AlexisJ16/tapete_interactivo/docs/hardware/grafico/grafico_tapete_A3.pdf

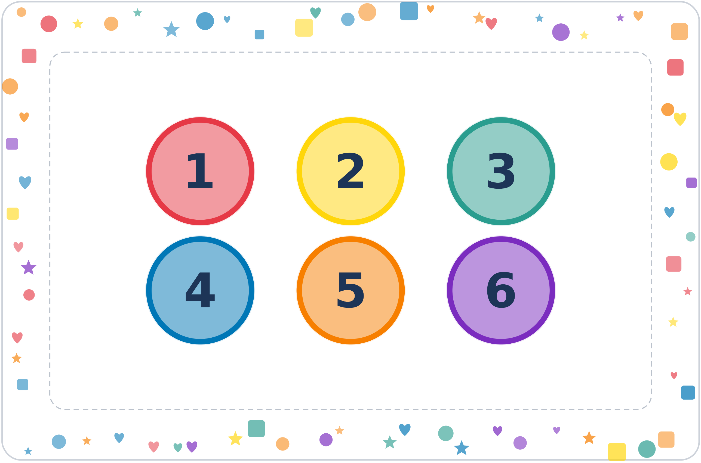
[picture p11: figure]

CALIBRACIÓN 100 mm — medir con regla; debe dar 100 mm exactos

TAPETE INTERACTIVO — plantilla a escala real 39 × 26 cm. IMPRIMIR AL 100% / TAMAÑO REAL — NO usar “ajustar a página”. Recortar por las marcas. Acetato A3 · alinear cada círculo sobre su grupo de LEDs (el borde es decorativo) · verificar la regla de 100 mm antes de montar.
