AlexisJ16/tapete_interactivo/docs/articulo/Desarrollo de tapete interactivo con secuencias de luces y sonidos para implementación en terapias de niños con síndrome de Down V3.docx

# FORMATO ANTEPROYECTO DE TRABAJO DE GRADO

(MODALIDADES INVESTIGACION Y ESTUDIO DE CASO*)

*La modalidad de estudio de caso aplica únicamente para programas de especialización

INFORMACIÓN BÁSICA
Programa académico al cual pertenece el estudiante | Ingeniería Electrónica
Nombre del (los) Estudiante (s): | Andrés Mauricio Restrepo Restrepo Christian Camilo Galeano Saldarriaga
Código o Cédula: 1143961668 1088311365 | E-mail: andres.restrepo03@usc.edu.co christian.galeano01@usc.edu.co | No. Cel.: 3155851907 3168296197
Nombre del director de trabajo de grado | Luis Carlos Rodríguez Timaná Vo Bo director
Título de la propuesta: (máx. 100 caracteres) | Desarrollo de un tapete interactivo que combina secuencias de luces y sonidos como herramienta de apoyo para terapias en niños con síndrome de Down.

Modalidad de Trabajo de Grado

Proyecto de Grado de Investigación | x | Estudio de caso

Grupo de investigación | GIEIAM X COMBA I+D
Línea de investigación (seleccione con una X la línea de investigación) | Logística, operaciones, productividad y gestión de proyectos Instrumentación, automatización y sistemas inteligentes X Gestión y control de la contaminación ambiental Arquitectura de Tecnología Informática Computación Ubicua, Urbana y Móvil Desarrollo de Sistemas Informáticos Redes Inalámbricas para la Inclusión Digital y el Desarrollo Económico

CUERPO DEL ANTEPROYECTO

Introducción

(máximo 250 palabras)

El síndrome de Down, también conocido como trisomía 21, se produce cuando existe una copia adicional del cromosoma 21 en todas las células del individuo. Es considerado uno de los trastornos genéticos más prevalentes a nivel global, con una tasa de ocurrencia de 12,6 por cada 10.000 nacimientos (de Graaf et al., 2015). Los niños que presentan esta condición suelen evidenciar una disminución en la fuerza muscular y alteraciones en el funcionamiento del cerebelo, lo que compromete su equilibrio y control postural. Como consecuencia, su patrón de marcha se torna inestable y se caracteriza por pasos más cortos. Estas condiciones derivan en un retraso en el desarrollo de habilidades motoras gruesas (Okada et al., 2019).

Los juegos de simulación ofrecen un gran potencial terapéutico para personas con neurodiversidad, mejorando sus funciones ejecutivas y promoviendo la inclusión tanto en entornos educativos como terapéuticos. Aunque los resultados son prometedores, se necesita más investigación para optimizar el diseño de los juegos, evaluar sus efectos a largo plazo y estandarizar la calidad de los estudios (Timaná et al., 2024).

Este proyecto busca el desarrollo de un tapete interactivo diseñado para intervenir las habilidades cognitivas y motoras en niños con síndrome de Down, combinando secuencias de luces, sensores de presión, junto con un software de análisis de datos en PC para evaluar el progreso del usuario. El sistema ofrece tres modos de juego diseñados para estimular la memoria de trabajo, planificación motora, velocidad de respuesta y equilibrio. El tapete incluirá secuencias de luz memorizadas y saltos en patrones sobre él.

Planteamiento del problema

(máximo 500 palabras)

Los niños con síndrome de Down enfrentan múltiples retos en su desarrollo cognitivo y motor, los cuales demandan intervenciones especializadas. Uno de los aspectos más críticos es la memoria de trabajo, una función clave para mantener y manipular información de forma inmediata. Las limitaciones en esta habilidad repercuten directamente en la capacidad de los niños para seguir instrucciones, recordar secuencias y comprender información compleja, afectando su rendimiento tanto en actividades cotidianas como en contextos educativos (Covaci et al., 2015).

Además, la planificación y secuenciación motora representan un obstáculo considerable. La ejecución de movimientos en un orden específico, crucial para actividades como vestirse, atarse los zapatos o realizar tareas escolares, se ve comprometida. La coordinación estructurada, necesaria para el desarrollo de habilidades motoras finas y gruesas, también se ve afectada, lo que puede limitar su participación en juegos y deportes.

La velocidad de procesamiento y reacción es otro factor crítico. Los niños con síndrome de Down suelen experimentar tiempos de respuesta más prolongados ante estímulos visuales o auditivos. Esta lentitud puede dificultar su interacción en juegos y actividades que requieren rapidez en la toma de decisiones, así como su capacidad para seguir el ritmo de las clases y las conversaciones (Lukowski et al., 2019).

Las alteraciones en la postura y el control del cuerpo son también comunes. El equilibrio y la coordinación se ven comprometidos, lo que puede afectar su movilidad y desempeño en actividades físicas. Estas dificultades pueden limitar su exploración del entorno y su participación en juegos activos, lo que, a su vez, puede impactar su desarrollo social y emocional (Galli et al., 2008).

A pesar de la existencia de terapias motoras y juegos tradicionales, muchos de estos métodos carecen de la capacidad de proporcionar retroalimentación inmediata y personalizada. La falta de un seguimiento detallado del progreso del niño dificulta la adaptación de los niveles de dificultad, lo que puede resultar en frustración y desmotivación (Okada et al., 2019).

Es imperativo desarrollar un sistema innovador que integre tecnología de sensores y aprendizaje adaptativo. Esta herramienta debe ser capaz de entrenar habilidades cognitivas y motoras de manera dinámica y motivadora, proporcionando retroalimentación inmediata y ajustando los niveles de dificultad según el rendimiento individual de cada niño. La capacidad de medir el desempeño y realizar un seguimiento detallado del progreso permitirá a los terapeutas y educadores adaptar las intervenciones y maximizar el potencial de cada niño.

En este contexto, surge la necesidad de explorar cómo este tipo de soluciones tecnológicas pueden integrarse de manera efectiva en entornos terapéuticos reales. Por tanto, el presente proyecto no solo se enfoca en el desarrollo técnico de un tapete interactivo con estímulos visuales y auditivos, sino también en la evaluación de su comportamiento durante su implementación en sesiones terapéuticas. Así, se plantea como pregunta de investigación: ¿Cuáles son los elementos clave en el desarrollo de un tapete interactivo con luces y sonidos que favorezcan su efectividad como herramienta de apoyo terapéutico para niños con síndrome de Down?

Justificación

(máximo 500 palabras)

Tal como se ha señalado, los niños con síndrome de Down presentan múltiples dificultades en áreas fundamentales del desarrollo, entre ellas la memoria de trabajo, la planificación y ejecución motora, la velocidad de procesamiento y reacción, así como el control postural. Estas limitaciones pueden afectar de manera significativa su calidad de vida, restringiendo su autonomía, su participación en actividades cotidianas y su desarrollo integral (Lukowski et al., 2019).

Por otro lado, las terapias convencionales y los juegos tradicionales empleados en este contexto presentan diversas limitaciones. En muchos casos, no ofrecen retroalimentación inmediata ni personalizada, elemento esencial para que los niños puedan identificar errores, corregirlos y fortalecer su aprendizaje. La ausencia de este tipo de retroalimentación puede disminuir la motivación y dificultar el progreso. Asimismo, la falta de un sistema que registre el avance del niño impide adaptar los niveles de dificultad de manera adecuada, lo cual complica a padres y terapeutas el seguimiento efectivo de la intervención. Además, gran parte de estas actividades no han sido diseñadas considerando las particularidades del síndrome de Down, lo que puede resultar en ejercicios poco retadores o excesivamente complejos, provocando frustración y desinterés en los participantes (Minh et al., 2021).

Ante este panorama, surge la necesidad de desarrollar una solución innovadora que combine los avances tecnológicos con los principios pedagógicos y terapéuticos más actuales. Esta solución debe ser capaz de proporcionar retroalimentación inmediata y personalizada, realizar un seguimiento detallado del progreso del niño y de adaptar los niveles de dificultad de las actividades de manera dinámica.

Se espera que este juego interactivo sea una herramienta valiosa para complementar las terapias tradicionales y para potenciar el desarrollo cognitivo y motor de los niños con síndrome de Down. Al ofrecer una experiencia de aprendizaje interactiva y motivadora, este juego puede ayudar a estos niños a superar sus dificultades y a alcanzar su máximo potencial.

Este proyecto está alineado con dos Objetivos De Desarrollo Sostenible (ODS) de la Organización de las Naciones Unidas (ONU) (Objetivos de Desarrollo Sostenible | Programa De Las Naciones Unidas Para El Desarrollo, n.d.). En primer lugar, contribuye al ODS 3: SALUD Y BIENESTAR, al promover el acompañamiento y la atención especializada a los niños con síndrome de Down; y, en segundo lugar, está alineado con el ODS 10: REDUCCION DE LAS DESIGUALDADES, al contribuir a la inclusión social de esta población.

Objetivos

OBJETIVO GENERAL:

Desarrollar un tapete interactivo que combine secuencias de luces y sonidos como herramienta de apoyo en terapias para niños con síndrome de Down.

OBJETIVOS ESPECIFICOS:

- Diseñar el sistema electrónico del tapete interactivo, que integre sensores de presión, módulos de iluminación LED RGB y componentes de salida de audio para implementarlo en terapias cognitivas y motrices en niños con síndrome de Down.
- Desarrollar el firmware del microcontrolador encargado de la interacción entre los sensores, las secuencias de luces y los sonidos, implementando diferentes modos terapéuticos adaptables a las necesidades de los niños con síndrome de Down.
- Evaluar el comportamiento funcional del prototipo en un entorno terapéutico real.

Marco teórico y estado del arte

(Debe incluir el marco contextual y el marco legal en caso de ser necesario Pueden incluirse figuras y tablas)

(máximo 1500 palabras)

Marco Teórico

1. Síndrome de Down y su impacto en el desarrollo infantil
  1.1 Definición y características generales

El síndrome de Down, también conocido como trisomía 21, es un trastorno genético causado por la presencia de una copia adicional del cromosoma 21. Esta condición afecta múltiples áreas del desarrollo infantil, tanto físico como cognitivo. En el plano físico, es común observar hipotonía muscular, laxitud ligamentosa y retraso en el desarrollo motor grueso, lo que repercute en habilidades como el equilibrio y la coordinación. A nivel cognitivo, se presentan dificultades en funciones como la memoria de trabajo, la atención y la planificación, lo que puede impactar el aprendizaje y la autonomía del niño en contextos escolares y sociales (Okada et al., 2019).

  1.2 Alteraciones motoras en niños con síndrome de Down

Los niños con síndrome de Down presentan hipotonía muscular y dificultades de equilibrio, lo que se traduce en una marcha inestable y retrasos en el desarrollo motor grueso. Estas dificultades no solo afectan su movilidad, sino también su independencia funcional y su interacción con el entorno (Okada et al., 2019).

  1.3 Intervenciones terapéuticas orientadas al desarrollo motor

Diversas terapias, como la fisioterapia y la hipoterapia, han demostrado beneficios importantes. Mientras que la fisioterapia mejora la alineación corporal y fortalece el sistema musculoesquelético, la hipoterapia estimula el sistema vestibular y la orientación espacial, promoviendo un desarrollo motor más equilibrado y eficiente (Bevilacqua Junior et al., 2023).

2. Habilidades motoras: clasificación y evaluación
  2.1 Definición de habilidades motoras

Las habilidades motoras pueden definirse como secuencias aprendidas de movimientos que se combinan de manera coordinada para ejecutar una acción de forma suave, precisa y eficiente, con el propósito de dominar una tarea específica. Estas habilidades no son innatas, sino que se adquieren y refinan progresivamente a través de la práctica, la retroalimentación y la maduración del sistema neuromuscular (van der Fels et al., 2015). Su desarrollo es fundamental para la autonomía del individuo, ya que permiten desde acciones básicas como caminar o alimentarse, hasta tareas más complejas como escribir, jugar o manipular objetos. Estas habilidades se agrupan en distintas categorías funcionales, que incluyen las habilidades motoras gruesas, finas, de coordinación bilateral, control de objetos, y rendimiento cronometrado, entre otras, dependiendo del tipo de actividad, la precisión requerida y la parte del cuerpo involucrada (van der Fels et al., 2015).

  2.2 Tipos de habilidades motoras
- Gruesas: correr, saltar, caminar, equilibrio.
- Finas: escritura, dibujo, manipulación precisa (van der Fels et al., 2015)
- Coordinación bilateral: sincronización de extremidades superiores e inferiores (van der Fels et al., 2015)
- Control de objetos: lanzar, atrapar o manejar herramientas (van der Fels et al., 2015)
- Rendimiento cronometrado: velocidad de ejecución de secuencias motoras.
- Puntuación motora total: indicador global que integra todas las categorías anteriores (van der Fels et al., 2015)
  2.3 Habilidades motoras en el contexto del síndrome de Down

Debido a la hipotonía y la disfunción neuromuscular, los niños con síndrome de Down suelen presentar dificultades en varias categorías motoras, por lo cual es necesario implementar estrategias lúdicas y terapéuticas para su fortalecimiento.

3. Habilidades cognitivas y funciones ejecutivas
  3.1 Definición y componentes principales

Las habilidades cognitivas se entienden como las acciones mentales o procesos de adquisición de conocimiento y comprensión a través del pensamiento, la experiencia y los sentidos.

Las funciones ejecutivas (https://sciencedirect.proxyusc.elogim.com/topics/psychology/executive-functions) se describen como habilidades cognitivas de orden superior que permiten el autocontrol y la regulación del comportamiento (van der Fels et al., 2015):

  3.2 Funciones ejecutivas relevantes
- Inhibición de respuesta: control de impulsos.
- Planificación: estructuración de pasos para alcanzar un objetivo (van der Fels et al., 2015).
- Atención: focalización en estímulos relevantes.
- Memoria de trabajo: retención y manipulación de información por períodos breves (van der Fels et al., 2015).
  3.3 Déficits cognitivos en el síndrome de Down

Los niños con esta condición suelen presentar dificultades en las funciones ejecutivas mencionadas, lo que puede afectar su desempeño académico y su autonomía diaria. La estimulación cognitiva es clave para favorecer su desarrollo integral.

4. Juegos serios como herramienta de intervención
  4.1 Definición y propósito

Los juegos serios combinan el entretenimiento con objetivos pedagógicos o terapéuticos, integrando dinámicas lúdicas con finalidades formativas o de intervención. A diferencia de los videojuegos convencionales, cuyo propósito principal es el ocio, los juegos serios están diseñados intencionalmente para desarrollar o fortalecer habilidades específicas en sus usuarios, ya sean de tipo cognitivo, motor, emocional o social (Timaná et al., 2024). Estos juegos pueden aplicarse en diversos contextos, como la educación, la rehabilitación, la salud mental o la inclusión, ofreciendo entornos seguros, motivadores y adaptativos. Gracias a su componente interactivo y personalizado, los juegos serios favorecen la participación activa, el aprendizaje significativo y la repetición voluntaria de tareas, lo que los convierte en herramientas valiosas para apoyar procesos de enseñanza y terapia.

  4.2 Aplicación en niños con necesidades educativas especiales

En el caso de niños con neurodiversidad como el síndrome de Down, los juegos serios han mostrado resultados positivos en la estimulación de funciones ejecutivas y en el desarrollo de habilidades motoras, al ofrecer un entorno seguro, motivador y adaptado, lo que los hace versátiles y aplicables en diversos campos, como la educación y la salud (Timaná et al., 2024).

  4.3 Juegos serios y desarrollo integral

El componente lúdico de estos juegos fomenta la motivación intrínseca, favoreciendo la repetición de tareas motrices y cognitivas sin generar frustración. Esto se traduce en mejoras significativas tanto en la coordinación como en la atención y memoria de trabajo (Timaná et al., 2024).

5. Integración conceptual: una perspectiva terapéutica y educativa

La combinación de enfoques terapéuticos tradicionales (como la fisioterapia) con herramientas innovadoras (como los juegos serios) ofrece una vía prometedora para intervenir en las áreas motoras y cognitivas en niños con síndrome de Down. Esta integración no solo mejora el rendimiento funcional, sino que también incrementa la motivación, la autoestima y la participación activa de los niños en su propio proceso de desarrollo.

Estado del arte

- VIC — Una interfaz de usuario tangible para entrenar las habilidades de memoria en niños con discapacidad intelectual

Se presenta el diseño y la tecnología de VIC, una interfaz de usuario tangible e inteligente diseñada para mejorar habilidades específicas de memoria en niños con discapacidad intelectual. VIC se enfoca en estimular la memoria sensorial o auditiva, la memoria a corto plazo y la memoria de trabajo o visoespacial.

Este sistema modular consta de un tablero con sensores y nueve cubos digitales, los cuales emiten luces y sonidos en respuesta a la manipulación y posición de los cubos. El diseño de VIC se basa en principios teóricos, prácticas clínicas y estudios previos sobre interfaces tangibles dirigidas a niños con discapacidades cognitivas e intelectuales.

Los resultados preliminares indican que VIC es fácil de usar, atractivo y genera compromiso en los usuarios. Estos aspectos son fundamentales para su adopción en programas de rehabilitación. La usabilidad y el atractivo del sistema se consideran requisitos clave para futuras investigaciones que evalúen la eficacia clínica de VIC en la rehabilitación de la memoria (Beccaluva et al., 2022).

- Efecto de una intervención basada en un entorno multisensorial para la evaluación de la propiocepción en niños con síndrome de Down: estudio de caso

Un Entorno Multisensorial (EMS) se presenta como una herramienta valiosa para estimular y entrenar los sistemas vestibular y propioceptivo en niños con síndrome de Down (SDC), mediante el uso de sensores y actividades terapéuticas. Este estudio piloto investigó los efectos de un protocolo de intervención con EMS, específicamente diseñado para mejorar la propiocepción a través de una plataforma de juego.

El estudio empleó un sistema basado en cámaras RGB-D para evaluar el desempeño funcional de los niños. Tres niños con SDC, con una edad promedio de nueve años, participaron en un protocolo de fisioterapia de 12 sesiones de juego terapéutico, cada una con una duración de 30 minutos y una frecuencia semanal.

Antes de la intervención, los niños presentaban perfiles propioceptivos deficientes y dispráxicos, con una puntuación promedio de 10,43 en una prueba de perfil psicomotor. Tras la implementación del EMS, se observó una mejora significativa, alcanzando una puntuación promedio de 16,44, lo que indica un perfil de desarrollo típico, estos resultados sugieren que el EMS puede ser una herramienta eficaz para mejorar la propiocepción en niños con SDC, con un impacto positivo en su desarrollo motor y funcional (Valencia-Jimenez et al., 2023).

- Diseño tecnológico de un tapete interactivo para la motricidad gruesa en niños con discapacidad

En esta investigación se expone cómo la Informática y la educación pueden unirse para diseñar materiales de aprendizaje innovadores, como parte de una iniciativa de inclusión dirigida a niños con discapacidad. El objetivo principal fue diseñar un tapete interactivo orientado a mejorar las habilidades de coordinación motriz gruesa en niños con discapacidad intelectual.

El tapete utiliza un microcontrolador Arduino, programado en un lenguaje de alto nivel, y cuenta con cinco botones luminosos. Cuando una luz se enciende, el niño identifica el botón correspondiente y lo pisa con una o ambas piernas, trabajando de esta manera su equilibrio y motricidad gruesa. El sistema proporciona retroalimentación visual mediante luces que indican si la acción realizada fue correcta.

El diseño de este juego educativo tecnológico, basado en circuitos electrónicos, demostró favorecer una mayor independencia en los niños, facilitando su integración social a través del juego con sus pares y, en última instancia, contribuyendo a mejorar su calidad de vida (Bernal Díaz et al., 2019).

- Una solución basada en juegos con juguetes interactivos para apoyar la extremidad superior para niños en edad preescolar con parálisis cerebral: un resultado preliminar

Se diseñaron dos juguetes interactivos para apoyar la rehabilitación de la extremidad superior en niños de 2 a 5 años, utilizando un juego 2D libre y sin reglas. Un palo con sensores de movimiento y un guante con sensores de fuerza y una pelota, rastreaban los movimientos de hombro y la fuerza de agarre, los juguetes interactuaban con el juego, motivando a los niños a repetir los movimientos de rehabilitación.

Los niños con parálisis cerebral mostraron mejoras en cinco días, aumentando la abducción del hombro de 70 a más de 100 grados y la fuerza de agarre de 80-90 gramos a 1 Newton. Esto demostró que la solución fue factible y entretenida, logrando que la repetición de movimientos fuera atractiva y viable a largo plazo (Minh et al., 2021).

- Juguetes interactivos diseñados para niños con parálisis cerebral

Los niños con parálisis cerebral requieren rehabilitación intensiva para mejorar su control motor fino. Sin embargo, los ejercicios tradicionales suelen ser monótonos y difíciles de mantener. Para hacer la rehabilitación más atractiva, se están desarrollando juguetes interactivos.

Este estudio se enfoca en crear juguetes modulares, compatibles con bloques LEGO, que permitan entrenar manos y brazos de diversas maneras. Los juguetes utilizan colores vibrantes, diseños de animales y retroalimentación visual y auditiva para ser más atractivos. Además, sus piezas intercambiables permiten ajustar la dificultad de los ejercicios, haciéndolos accesibles para diferentes niños con parálisis cerebral.

Las pruebas iniciales en hospitales muestran que los juguetes son populares y fáciles de usar. Se recopilan datos sobre el rendimiento de los niños para evaluar el impacto a largo plazo de los juguetes en su rehabilitación, lo que ayuda a los terapeutas a seguir su progreso y personalizar los tratamientos (Bian et al., 2020).

Los estudios revisados evidencian el impacto positivo de las tecnologías interactivas y multisensoriales en el desarrollo de habilidades motoras y cognitivas en niños con discapacidad. Herramientas como VIC, los entornos multisensoriales y los juguetes interactivos han mostrado ser efectivas para mejorar la memoria, la coordinación motriz y la propiocepción, al mismo tiempo que motivan a los niños a través de un enfoque lúdico. Los resultados destacan su capacidad para promover la participación de los niños, contribuyendo a su desarrollo, autonomía e integración social, lo que abre nuevas oportunidades para la rehabilitación y la inclusión en el ámbito educativo y terapéutico, como por ejemplo el uso de tapetes multisensoriales que permita una intervención mientras los pacientes están jugando.

Metodología

(Puede incluir esquemas y tablas. Máximo 1500 palabras).

El presente proyecto propone el desarrollo de un tapete interactivo que incorpore elementos lúdicos y terapéuticos diseñados específicamente para estimular las áreas de desarrollo cognitivo y motor que presentan dificultades en los niños con síndrome de Down. Este tapete se basará en principios de aprendizaje multisensorial, utilizando estímulos visuales y auditivos para crear una experiencia de aprendizaje inmersiva y atractiva.

El tapete contará con diferentes niveles de dificultad, buscando que las actividades sean siempre desafiantes pero alcanzables. Además, proporcionará retroalimentación inmediata y personalizada sobre el desempeño del niño, ayudándole a comprender sus errores y a mejorar su precisión y velocidad.

El tapete también incluirá un sistema de seguimiento detallado del progreso del niño, registrando datos sobre su rendimiento en cada actividad y generando informes que puedan ser utilizados por terapeutas y padres para evaluar la efectividad de las intervenciones y realizar ajustes si es necesario.

Teniendo en cuenta esto el desarrollo del tapete se divide en tres fases principales: diseñar el sistema electrónico que integre sensores de presión, luces LED RGB y componentes de salida de audio. Además de un sistema de monitoreo en PC para analizar el desempeño y finalmente evaluar la efectividad del tapete mediante pruebas con usuarios reales. A continuación, se describe cada una de estas etapas.

1. Diseñar el sistema electrónico que integre sensores de presión, luces LED RGB y componentes de salida de audio

Microcontrolador y sensores

Para el prototipo se emplearán componentes de fácil instalación. En primer lugar, se utilizará un módulo de desarrollo basado en el microcontrolador ESP32, un dispositivo versátil y de bajo consumo que integra conectividad Wi-Fi y Bluetooth, capacidad de procesamiento local y múltiples interfaces de entrada/salida (GPIO, I²C, SPI, ADC, entre otras). Estas características lo hacen ideal para adquirir, procesar y transmitir los datos generados por el sistema. En segundo lugar, se incorporarán sensores de presión tipo FSR (Force Sensitive Resistor), cuya resistencia eléctrica disminuye al aumentar la fuerza aplicada; esta propiedad permite estimar presión o carga puntual sobre una superficie. Los FSR son flexibles, económicos y fáciles de integrar en circuitos electrónicos, por lo que resultan especialmente adecuados para detectar la pisada del niño en cada casilla del tapete interactivo.

Luces LED

Se emplearán tiras de LED RGB WS2812B, ampliamente utilizadas en sistemas interactivos por su capacidad de control individual por pixel (a través de un solo pin de datos). Estas luces se utilizarán para crear un entorno lúdico, atractivo y responsivo durante la actividad del tapete. Cada casilla del tapete podrá iluminarse con distintos colores para brindar retroalimentación visual inmediata ante la pisada del niño, indicar turnos, señalar instrucciones o representar niveles de dificultad. Además, los efectos de iluminación dinámica (como transiciones, parpadeos o secuencias) ayudarán a mantener la atención y reforzar el aprendizaje a través de estímulos visuales.

Uso de altavoces

Se integrarán altavoces de pequeño tamaño controlados mediante salidas PWM o módulos de audio (como DFPlayer Mini), con el fin de emitir sonidos motivadores, efectos de refuerzo positivo, instrucciones verbales y pistas auditivas.
Los sonidos se adaptarán al modo de juego seleccionado, permitiendo que el sistema guíe al niño con mensajes como “Muy bien”, “Próximo paso”, o alertas ante errores, lo cual favorece una experiencia inmersiva y multisensorial. Esta estrategia no solo mejora la participación activa, sino que también fortalece la asociación entre acción, estímulo y respuesta, clave en procesos de intervención cognitiva.

Material del tapete

Se utilizará un material suave, con estampados amigables teniendo en cuenta el propósito del juego logrando generar confianza en los niños.

Batería recargable de litio

Permitirá la portabilidad del tapete y su uso sin depender de una conexión eléctrica directa.

2. Implementar un sistema de monitoreo en PC para analizar el desempeño

Conexión Wi-Fi/Bluetooth

El sistema contará con conectividad Wi-Fi o Bluetooth para permitir la comunicación entre los sensores, el microcontrolador ESP32 y la interfaz de monitoreo en la PC. Esta conexión facilitará el almacenamiento de datos y el seguimiento del desempeño del usuario en tiempo real.

Configuración del ESP 32

El ESP32 será configurado para conectarse a una red Wi-Fi, estableciendo un protocolo de comunicación eficiente y confiable que garantice la transmisión correcta de los datos recolectados por los sensores hacia el software de análisis.

Software en PC (Python)

La interfaz desarrollada en Python permitirá visualizar el desempeño del niño, gestionar su progreso y realizar ajustes personalizados en la dificultad de los juegos. Este entorno brindará a terapeutas y padres herramientas útiles para el acompañamiento y seguimiento terapéutico.

3. Evaluar la efectividad del tapete mediante pruebas con usuarios reales

Lectura de aciertos y/o errores en cantidad de tiempo y demás variables

Las pruebas se llevarán a cabo en una fundación que atiende a niños con síndrome de Down, durante un periodo de cinco semanas, con dos sesiones semanales de tres horas cada una. Este tiempo se ha estimado como adecuado para implementar las sesiones con el prototipo y observar su desempeño en un entorno terapéutico real.

Durante estas sesiones se recopilarán datos cuantitativos relacionados con el uso del tapete, tales como el número de aciertos y errores en cada dinámica, el tiempo de respuesta ante estímulos, y la frecuencia de interacción con los elementos del sistema. Estos indicadores permitirán analizar el comportamiento del dispositivo en condiciones de uso real, así como su capacidad de respuesta, estabilidad y facilidad de uso por parte de los niños.

Complementariamente, se realizará un seguimiento cualitativo a través de entrevistas semiestructuradas dirigidas a los docentes y/o padres de familia, con el fin de recopilar percepciones sobre la usabilidad, el nivel de motivación generado en los niños, la claridad de las instrucciones, y la adaptabilidad del tapete al contexto terapéutico. Esta información permitirá enriquecer el análisis funcional del sistema desde una perspectiva experiencial.

Cabe resaltar que el objetivo de estas pruebas no es medir mejoras clínicas en los niños, sino evaluar cómo se comporta el tapete en términos de funcionalidad, interacción usuario-dispositivo y adaptación a la dinámica de las sesiones terapéuticas. Para ello, se gestionará la aprobación del comité de ética correspondiente y se desarrollará el consentimiento informado, garantizando la participación ética y voluntaria de todos los involucrados.

El análisis de los datos incluirá estadística descriptiva, como promedios y desviaciones estándar de los indicadores recogidos. En caso de aplicar diferentes modos de juego o configuraciones, se utilizará análisis de varianza (ANOVA) para comparar el desempeño del sistema bajo distintas condiciones. De forma exploratoria, se podrá aplicar un análisis de regresión simple para observar posibles patrones entre variables como tiempo de uso e interacción, sin implicar evaluaciones sobre mejoras cognitivas o motoras. Los resultados permitirán establecer conclusiones sobre la viabilidad técnica y funcional del tapete en contextos terapéuticos reales.

Protocolo de Pruebas

El protocolo de pruebas se llevará a cabo en un entorno controlado, con la participación de niños diagnosticados con síndrome de Down. Las pruebas se estructurarán en tres fases: inicial, intermedia y final. En la fase inicial, se realizará una sesión exploratoria para familiarizar a los niños con el tapete y registrar una línea base sobre su nivel de interacción con el sistema (frecuencia de respuestas, comprensión de instrucciones, tiempos de respuesta, entre otros). Durante las fases intermedia y final, se aplicarán los distintos modos de juego del tapete, con dinámicas progresivas de dificultad, monitoreando de manera continua el desempeño mediante el sistema de registro en PC.

Los parámetros a evaluar incluirán el número de aciertos y errores, el tiempo de respuesta ante los estímulos del sistema, la continuidad de la interacción, y la capacidad del tapete para responder de manera estable y coherente a las acciones del usuario. Además, se recogerán percepciones cualitativas por parte de los terapeutas y padres sobre aspectos como la facilidad de uso, el nivel de atención que despierta en los niños, la adecuación de los estímulos, y la integración del tapete en la rutina terapéutica.

Los datos cuantitativos se analizarán mediante estadística descriptiva (medias, desviaciones estándar, frecuencias), y se podrá aplicar análisis de varianza (ANOVA) si se desea comparar el comportamiento del sistema en distintos modos de juego. No se realizará evaluación de impacto clínico o terapéutico directo, sino una valoración del comportamiento funcional del prototipo, su nivel de interacción con los usuarios y su adaptabilidad al entorno terapéutico.

El diagrama de flujo que se observa en la Figura 1, permite resumir la metodología a implementar para dar respuesta al problema planteado.

Diagrama de flujo

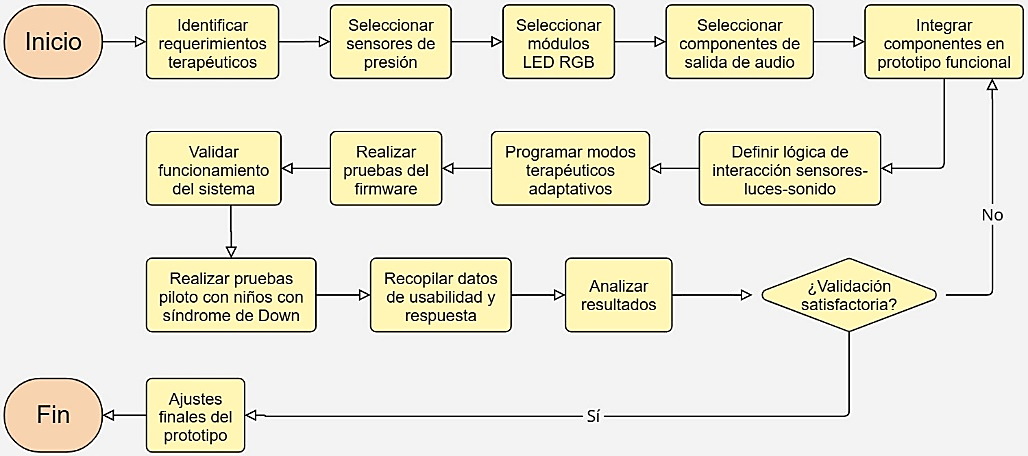
[picture p12: figure]

Figura 1. Diagrama de flujo del tapete interactivo.

Fuente: Propia.

Topología esperada

El diseño que se presenta en la figura 2 permite la adquisición, transmisión y visualización de los datos en tiempo real, en la topología se observa el ESP 32 como el microcontrolador encargado del control y procesamiento de los datos, a su vez el tapete cuenta con sensores de presión y luces LED, finalmente los datos son enviados al software Python que se encuentra instalado en el PC donde se podrá visualizar el desempeño y progreso de cada uno de los usuarios

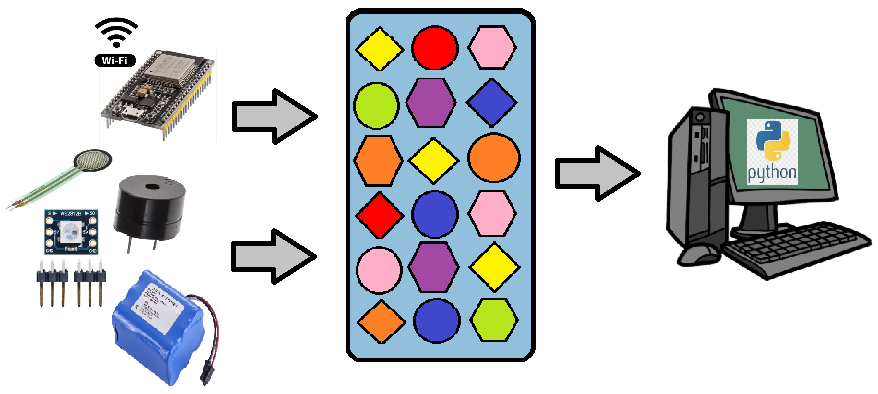
[picture p13: figure]

Figura 2. Topología esperada del tapete interactivo.

Fuente: Propia.

Cronograma de actividades

En la tabla 1 se puede observar el cronograma de actividades proyectadas en 6 meses y a su vez como aportan a cada uno de los objetivos específicos. Las actividades 1 y 2 se realizarán en simultaneo en el primer mes, para las actividades 3 y 4 se dispondrá de 2 meses ya que se inicia con la programación e implementación, la actividad 5 se llevará a cabo en el lapso de 1 mes para visualizar desempeño y realizar los ajustes necesarios, las actividades 6 y 7 hacen parte de la toma de datos y pruebas finales, por último la actividad 8 corresponde a la elaboración del informe final que se realizara en las últimas dos semanas cuando ya se tengan los resultados finales

Tabla 1. Cronograma del proyecto.

Mes Actividad | Mes 1 | Mes 2 | Mes 3 | Mes 4 | Mes 5 | Mes 6
1. Selección y adquisición de componentes. | x
2. Diseño inicial del prototipo del tapete.
3. Programación y pruebas de sensores.
4. Integración conjunta de todos los componentes en diseño final.
5. Pruebas en software Python para visualizar desempeño y realizar ajustes personalizados en la dificultad del juego.
6. Toma de datos y pruebas piloto en laboratorio.
7. Pruebas con usuarios físicos.
8. Elaboración del informe final.

Presupuesto

En la tabla 2 se puede observar el presupuesto del proyecto el cual está diseñado para llevar a cabo el desarrollo del tapete interactivo, se contempla la inversión del microcontrolador ESP32, junto con sensores de presión, luces led, altavoces pequeños y baterías recargables. La USC aporta en especie con la dedicación del docente, mientras que la fuente externa financia la adquisición de equipos como el computador donde se instalara el software y los materiales mencionados anteriormente. Se reserva un monto para viáticos, transporte e imprevistos destinados para el lugar en donde se llevarán a cabo las pruebas con usuarios finales, en este caso los niños con síndrome de Down.

Tabla 2. Presupuesto del proyecto.

Concepto | USC | | Fuente Externa
| Efectivo | Especie | Efectivo | Especie
1.Personal - Estudiante - Profesor | | Docente:2´500.000
2.Viaticos | | | 200.000
3.Transporte | | | 150.000
4.Materiales | | | 600.000
5.Equipos | | | 2’000.000
6.Imprevistos | | | 200.000
TOTAL | | 2´500.000 | 3´150.000

Referencias bibliográficas

(Incluir únicamente las empleadas en el marco teórico y estado del arte)

Para la propuesta, relacionar las referencias utilizadas en la revisión inicial del tema propuesto. Se debe utilizar el formato APA. Las referencias se evaluarán de acuerdo con la calidad de las fuentes, la actualidad de la información y la consulta de referencias en inglés. Se pueden utilizar las bases de datos multidisciplinarias reconocidas como: EBSCO, PROQUEST, SCIENCE DIRECT, SCOPUS, ENGINEERING INFORMATIONS, DOAJ, E-REVISTAS, entre otras.

Para libros digitales consultar Openlibra, GoogleBooks, EBSCO, McGrawHill, entre otros. Todas las anteriores bases de datos están disponibles en el servidor de la Biblioteca de la USC.

Beccaluva, E., Riccardi, F., Gianotti, M., Barbieri, J., & Garzotto, F. (2022). VIC — A Tangible User Interface to train memory skills in children with Intellectual Disability. International Journal of Child-Computer Interaction, 32, 100376. https://doi.org/10.1016/J.IJCCI.2021.100376

Bernal Díaz, A., Teresa, M., Tirado, B., Sebastián, J., & Jiménez, B. (2019). DISEÑO TECNOLOGICO DE UN TAPETE INTERACTIVO PARA LA MOTRICIDAD GRUESA EN NIÑOS CON DISCAPACIDAD. Área temática: A.4 Procesos de Aprendizaje y Educación.

Bevilacqua Junior, D. E., Mello, E. C. de, Lage, J. B., Ribeiro, M. F., Ferreira, A. A., Teixeira, V. de P. A., & Espindula, A. P. (2023). Analysis of strength and electromyographic activity of lower limbs of individuals with down syndrome assisted in physiotherapy and hippotherapy. Journal of Bodywork and Movement Therapies, 36, 83–88. https://doi.org/10.1016/J.JBMT.2023.05.009

Bian, Y., Wang, X., Han, D., & Sun, J. (2020). Designed interactive toys for children with cerebral palsy. TEI 2020 - Proceedings of the 14th International Conference on Tangible, Embedded, and Embodied Interaction, 473–478. https://doi.org/10.1145/3374920.3374975

Covaci, A., Kramer, D., Augusto, J. C., Rus, S., & Braun, A. (2015). Assessing Real World Imagery in Virtual Environments for People with Cognitive Disabilities. 2015 International Conference on Intelligent Environments, 41–48. https://doi.org/10.1109/IE.2015.14

de Graaf, G., Buckley, F., & Skotko, B. G. (2015). Estimates of the live births, natural losses, and elective terminations with Down syndrome in the United States. American Journal of Medical Genetics, Part A, 167(4), 756–767. https://doi.org/10.1002/ajmg.a.37001

Galli, M., Chiara, R., Luca, M., Nunzio, T., Paolo, O., & and Albertini, G. (2008). Postural control in patients with Down syndrome. Disability and Rehabilitation, 30(17), 1274–1278. https://doi.org/10.1080/09638280701610353

Lukowski, A. F., Milojevich, H. M., & Eales, L. (2019). Cognitive Functioning in Children with Down Syndrome: Current Knowledge and Future Directions. In Advances in Child Development and Behavior (Vol. 56). https://doi.org/10.1016/bs.acdb.2019.01.002

Minh, P. C., Xuan, T. N., Van, T. D., & Minh, D. N. (2021). A game-based solution with interactive toys for supporting upper limb rehabilitation for preschool-aged children with Cerebral Palsy: A preliminary result. Journal of Applied Science and Engineering, 24(6), 867–874. https://doi.org/10.6180/jase.202112_24(6).0007

Objetivos de Desarrollo Sostenible | Programa De Las Naciones Unidas Para El Desarrollo. (n.d.). Retrieved February 23, 2025, from https://www.undp.org/es/sustainable-development-goals

Okada, S., Uejo, T., Hirano, R., Nishi, H., Matsuno, I., Muramatsu, T., Fujiwara, M., Miyake, A., Okada, Y., Fukunaga, S., & Ishikawa, Y. (2019). Assessing the Efficacy of Very Early Motor Rehabilitation in Children with Down Syndrome. The Journal of Pediatrics, 213, 227-231.e1. https://doi.org/10.1016/J.JPEDS.2019.05.038

Timaná, L. C. R., García, J. F. C., Filho, T. B., González, A. A. O., Monsalve, N. R. H., & Jimenez, N. J. V. (2024). Use of Serious Games in Interventions of Executive Functions in Neurodiverse Children: Systematic Review. JMIR Serious Games, 12. https://doi.org/10.2196/59053

Valencia-Jimenez, N. J., Ramirez-Duque, A. A., Rodriguez-Timana, L. C., Castillo-Garcia, J. F., Silveira, M. L., Luz, S. Da, Bastos, T., & Frizera-Neto, A. (2023). Effect of an Intervention Based on Multisensory Environment for Proprioception Assessment in Children With Down Syndrome: Case Study. IEEE Access, 11, 9326–9338. https://doi.org/10.1109/ACCESS.2023.3239589

van der Fels, I. M. J., te Wierike, S. C. M., Hartman, E., Elferink-Gemser, M. T., Smith, J., & Visscher, C. (2015). The relationship between motor skills and cognitive skills in 4–16 year old typically developing children: A systematic review. Journal of Science and Medicine in Sport, 18(6), 697–703. https://doi.org/10.1016/J.JSAMS.2014.09.007
