AlexisJ16/tapete_interactivo/docs/evidencia/caja/caja_tapa_puesta.jpeg

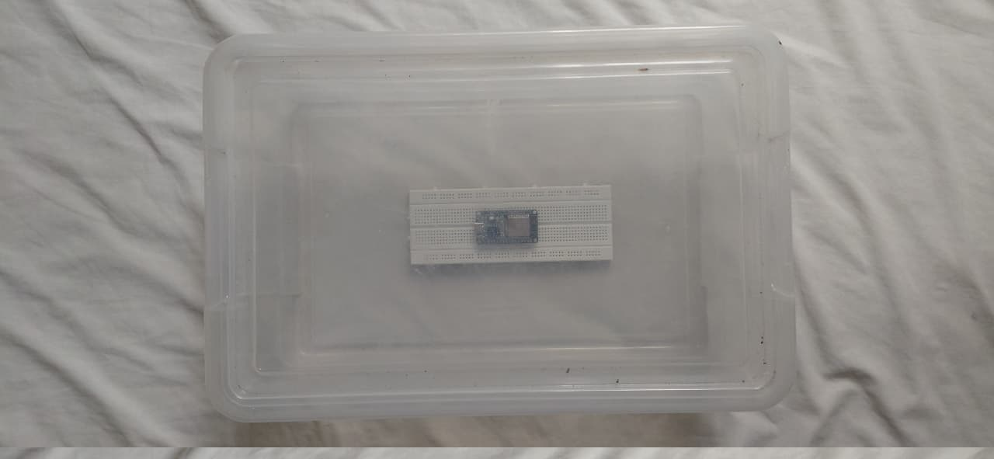
docs/evidencia/caja/caja_tapa_puesta.jpeg
