AlexisJ16/tapete_interactivo/docs/evidencia/caja/caja_y_tapa1.jpeg

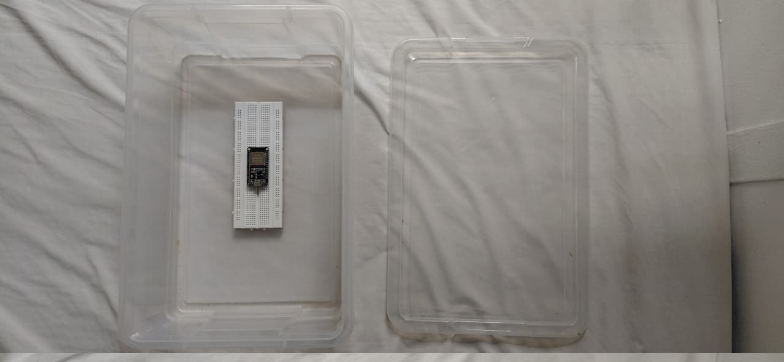
docs/evidencia/caja/caja_y_tapa1.jpeg
