AlexisJ16/tapete_interactivo/docs/evidencia/caja/caja_y_tapa2.jpeg

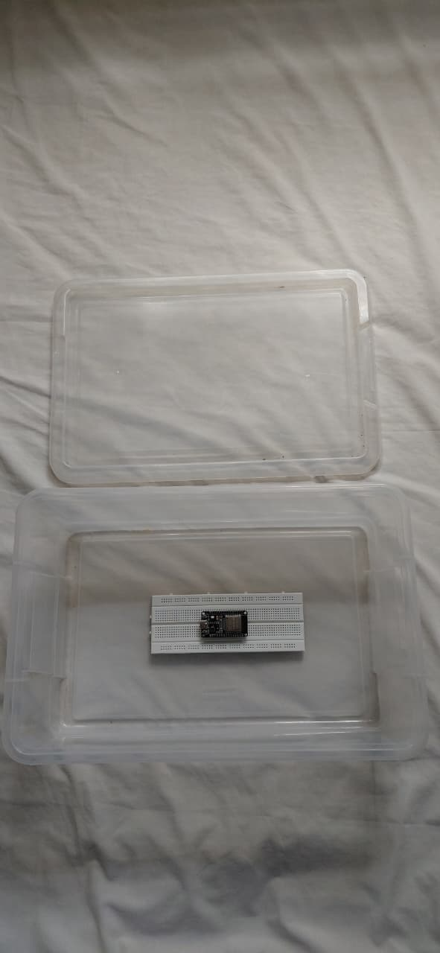
docs/evidencia/caja/caja_y_tapa2.jpeg
