AlexisJ16/tapete_interactivo/docs/evidencia/caja/tapa_con_refuerzo.jpeg

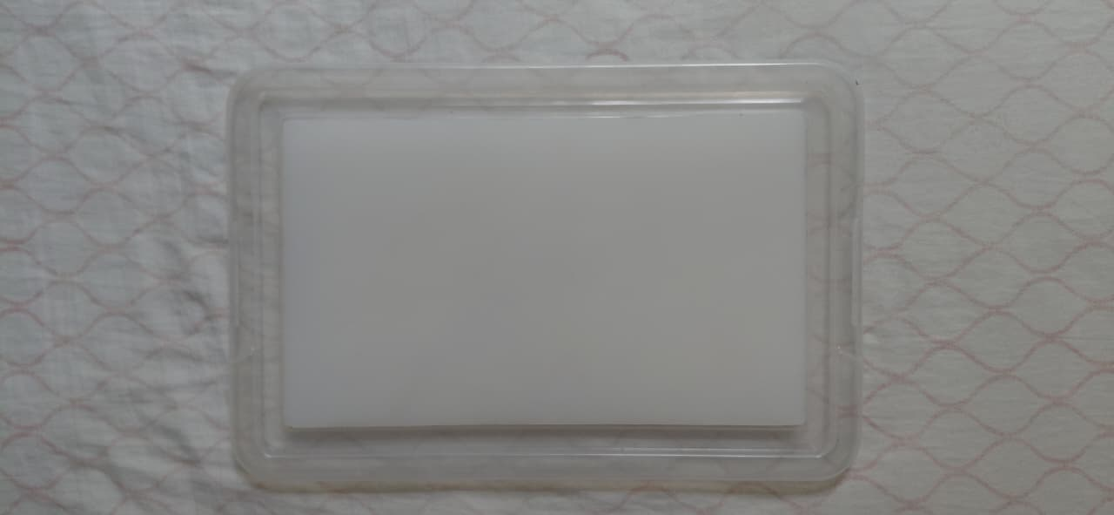
docs/evidencia/caja/tapa_con_refuerzo.jpeg
