AlexisJ16/tapete_interactivo/docs/evidencia/caja/tapa_y_refuerzos.jpeg

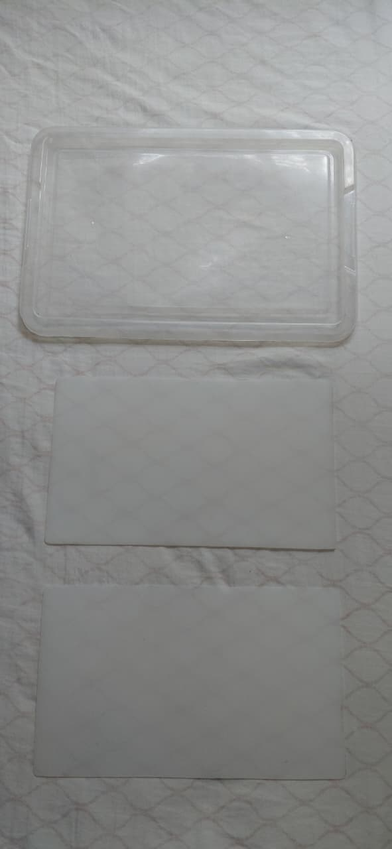
docs/evidencia/caja/tapa_y_refuerzos.jpeg
