AlexisJ16/tapete_interactivo/docs/evidencia/ejecucion/capturas/dashboard_inicio.png

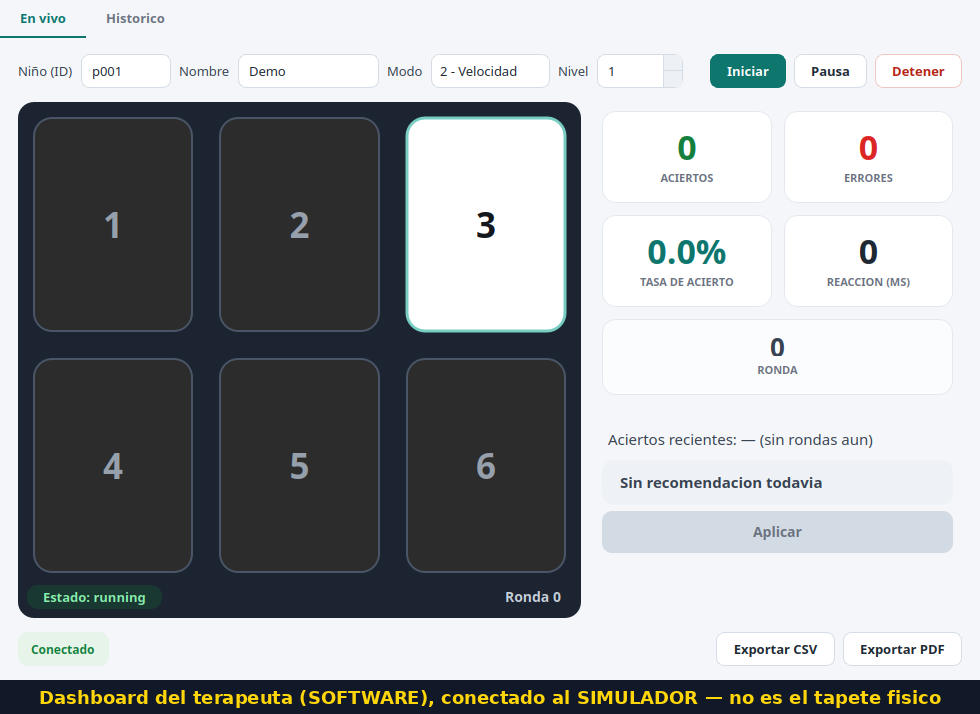
docs/evidencia/ejecucion/capturas/dashboard_inicio.png
