AlexisJ16/tapete_interactivo/docs/evidencia/ejecucion/capturas/dashboard_modo_velocidad.png

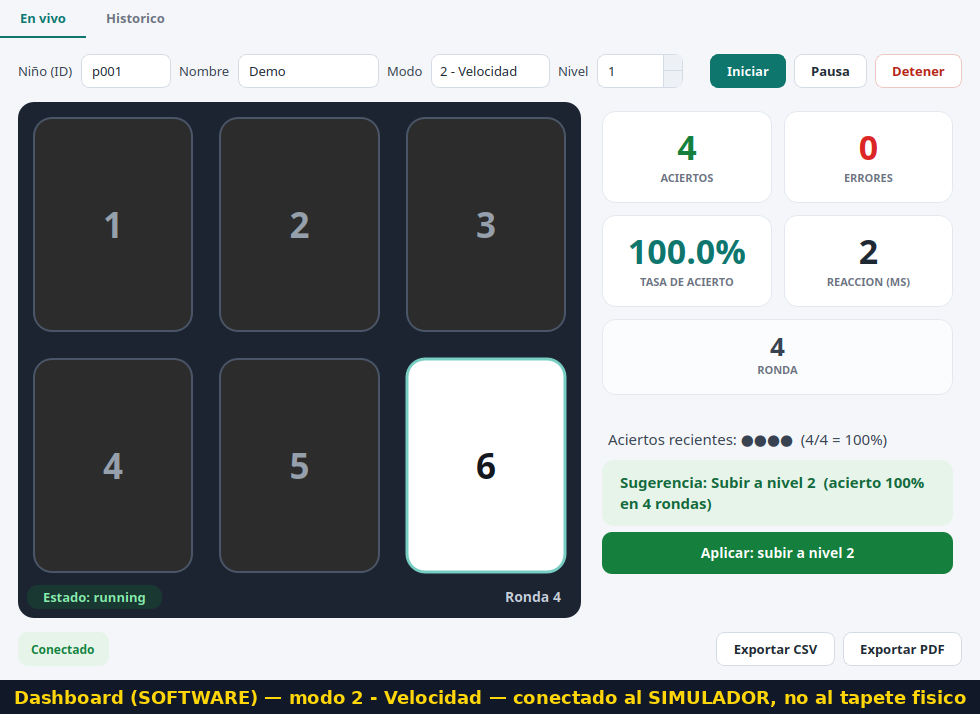
docs/evidencia/ejecucion/capturas/dashboard_modo_velocidad.png
