AlexisJ16/tapete_interactivo/docs/evidencia/ejecucion/capturas/sim_000.png

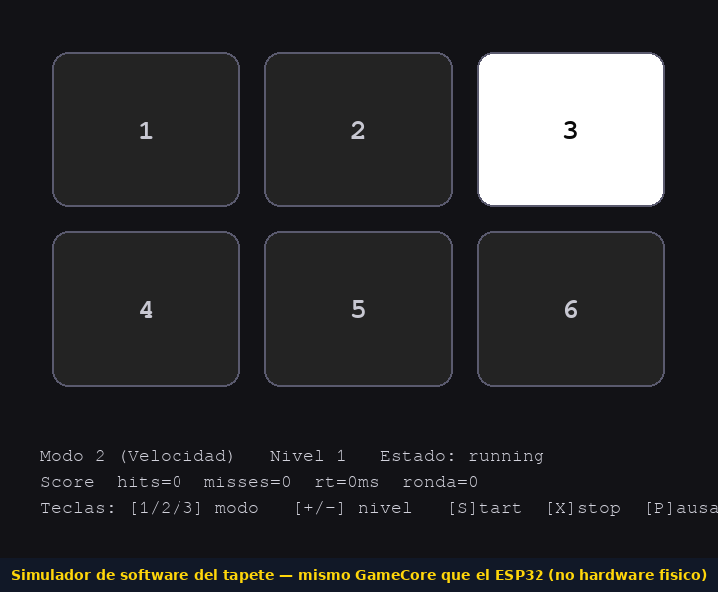
docs/evidencia/ejecucion/capturas/sim_000.png
