AlexisJ16/tapete_interactivo/docs/evidencia/ejecucion/capturas/sim_001.png

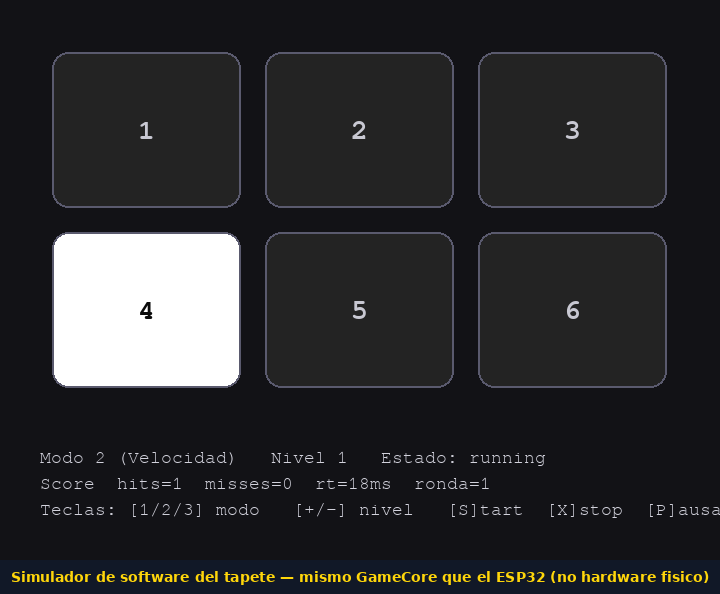
docs/evidencia/ejecucion/capturas/sim_001.png
