AlexisJ16/tapete_interactivo/docs/evidencia/ejecucion/capturas/sim_002.png

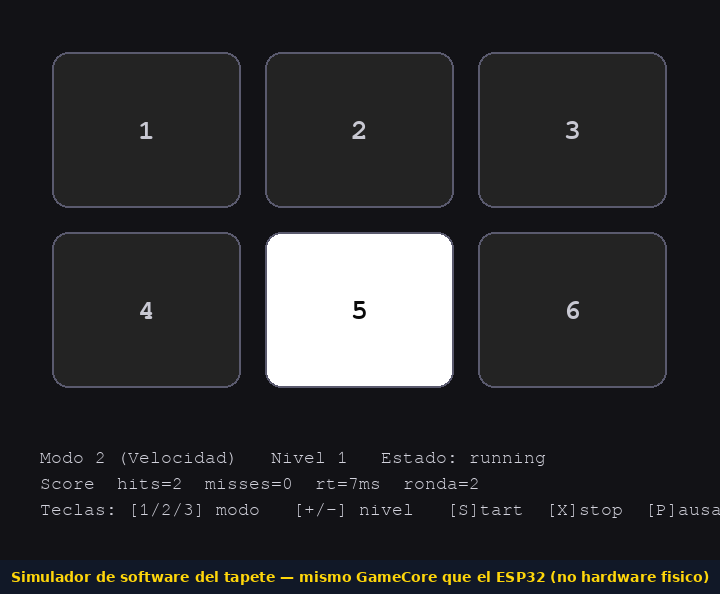
docs/evidencia/ejecucion/capturas/sim_002.png
