AlexisJ16/tapete_interactivo/docs/evidencia/ejecucion/capturas/sim_004.png

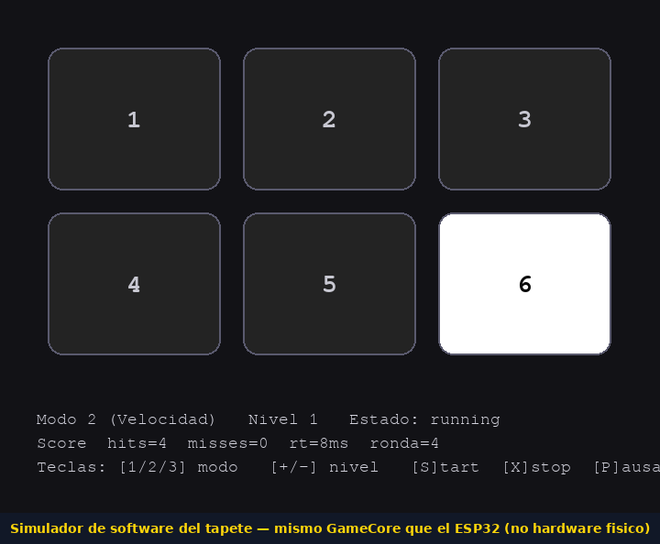
docs/evidencia/ejecucion/capturas/sim_004.png
