AlexisJ16/tapete_interactivo/docs/evidencia/esquematico.png

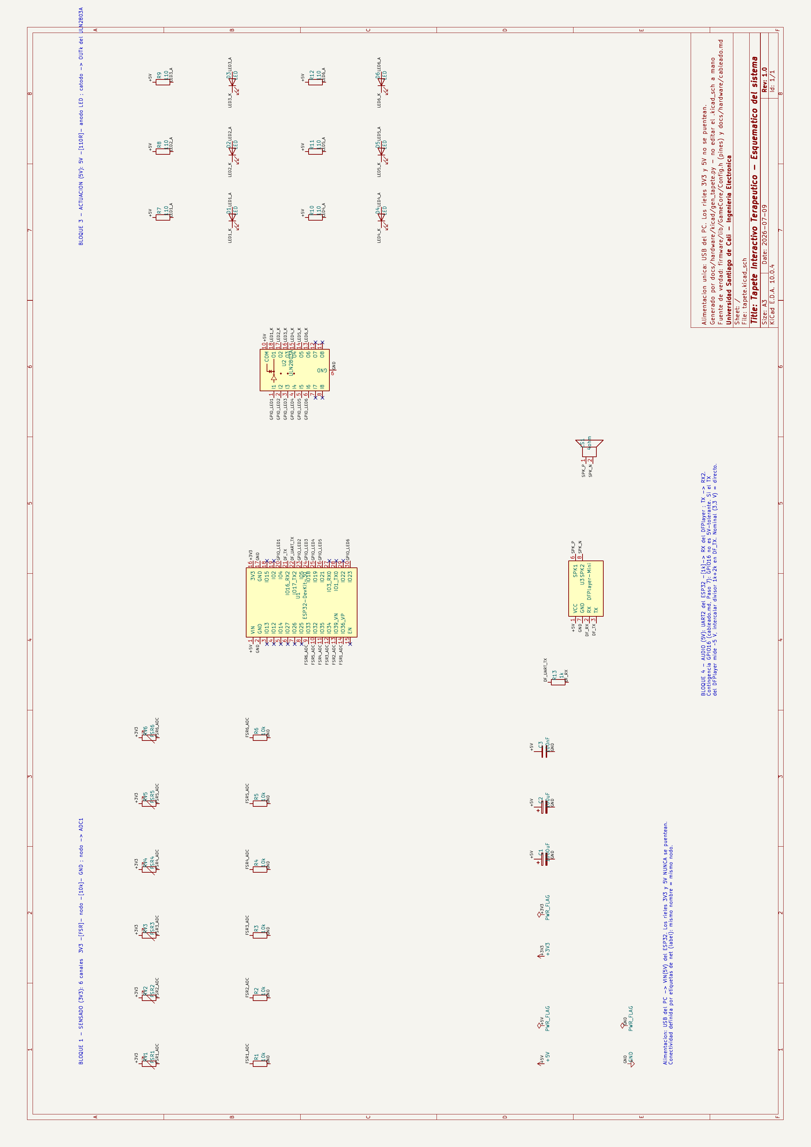
docs/evidencia/esquematico.png
