AlexisJ16/tapete_interactivo/docs/hardware/kicad/tapete.pdf

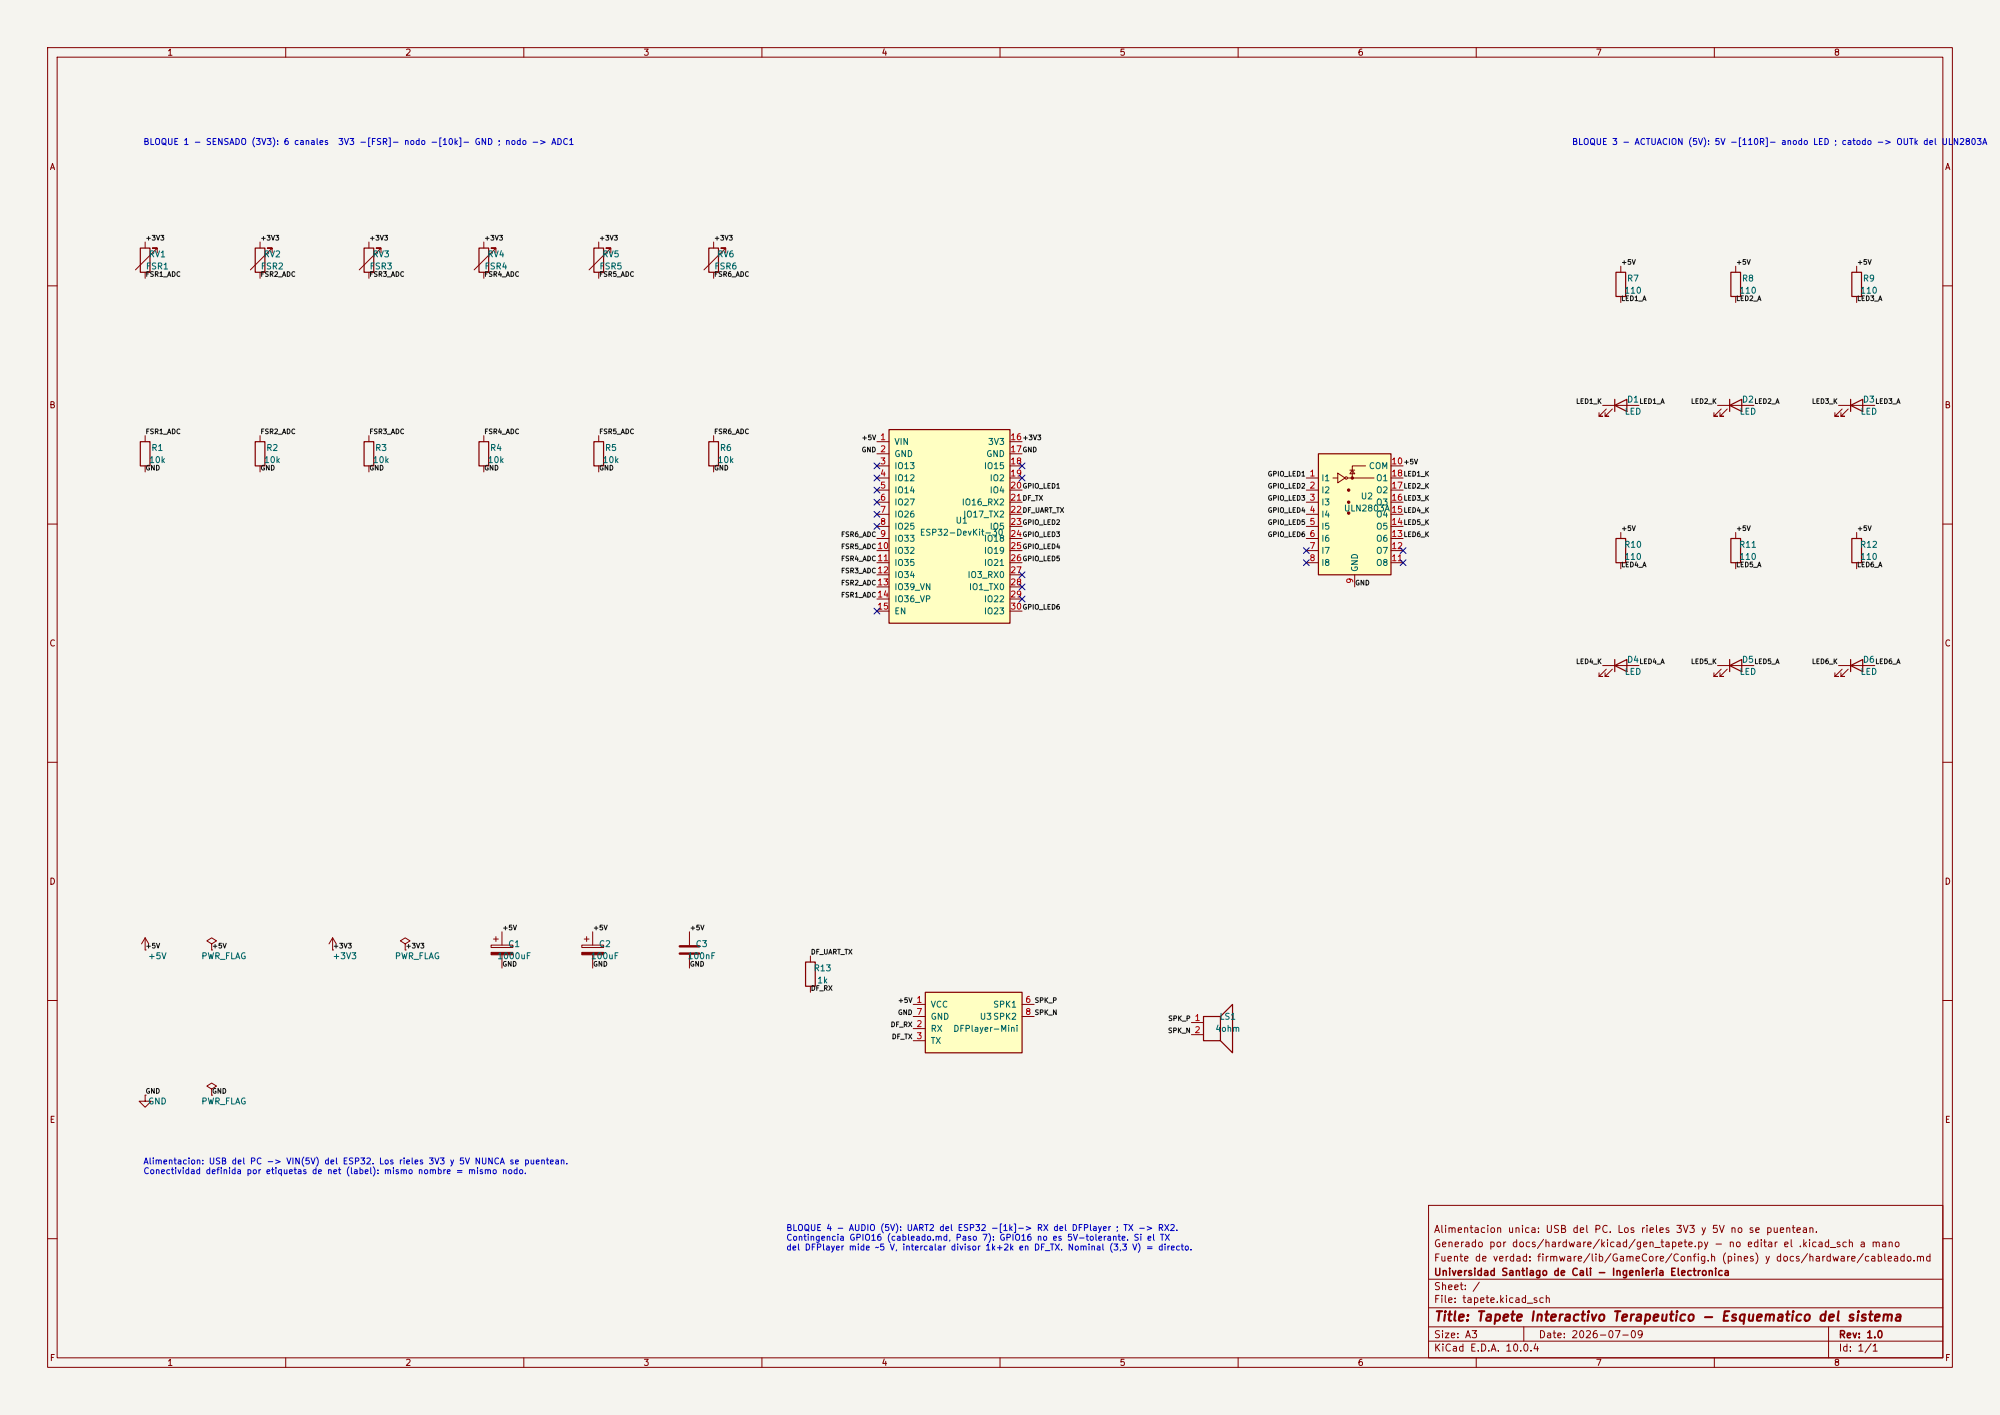
[picture p27: page 1]

DF_RX DF_UART_TX
Alimentacion unica: USB del PC. Los rieles 3V3 y 5V no se puentean. R13

del DFPlayer mide ~5 V, intercalar divisor 1k+2k en DF_TX. Nominal (3,3 V) = directo.

Generado por docs/hardware/kicad/gen_tapete.py - no editar el .kicad_sch a mano
Fuente de verdad: firmware/lib/GameCore/Config.h (pines) y docs/hardware/cableado.md
Universidad Santiago de Cali - Ingenieria Electronica
Sheet: /
File: tapete.kicad_sch
Title: Tapete Interactivo Terapeutico - Esquematico del sistema

Size: A3 | Rev: 1.0 | F Date: 2026-07-09
KiCad E.D.A. 10.0.4 | Id: 1/1
