AlexisJ16/tapete_interactivo/docs/evidencia/diagrama_bloques.pdf

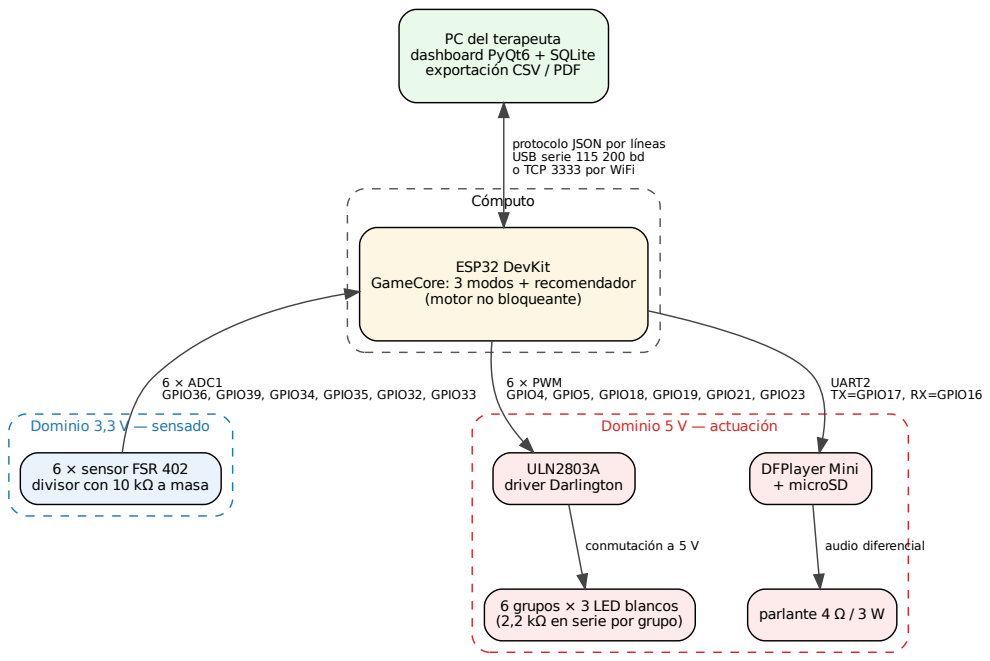
[picture p28: page 1]
Dominio 3,3 V — sensado; Dominio 5 V — actuación; ESP32 DevKit; 6 × ADC1 GPIO36, GPIO39, GPIO34, GPIO35, GPIO32, GPIO33; ULN2803A driver Darlington; 6 × PWM GPIO4, GPIO5, GPIO18, GPIO19, GPIO21, GPIO23; DFPlayer Mini + microSD; UART2 TX=GPIO17, RX=GPIO16; conmutación a 5 V; parlante 4 Ω / 3 W; audio diferencial

PC del terapeuta
dashboard PyQt6 + SQLite
exportación CSV / PDF

protocolo JSON por líneas
USB serie 115 200 bd
o TCP 3333 por WiFi
Cómputo

GameCore: 3 modos + recomendador

(motor no bloqueante)

6 × sensor FSR 402
divisor con 10 kΩ a masa

6 grupos × 3 LED blancos
(2,2 kΩ en serie por grupo)
