AlexisJ16/tapete_interactivo/docs/hardware/kicad/tapete.kicad_sch

## KiCad design docs/hardware/kicad/tapete.kicad_sch (2026-07-11)

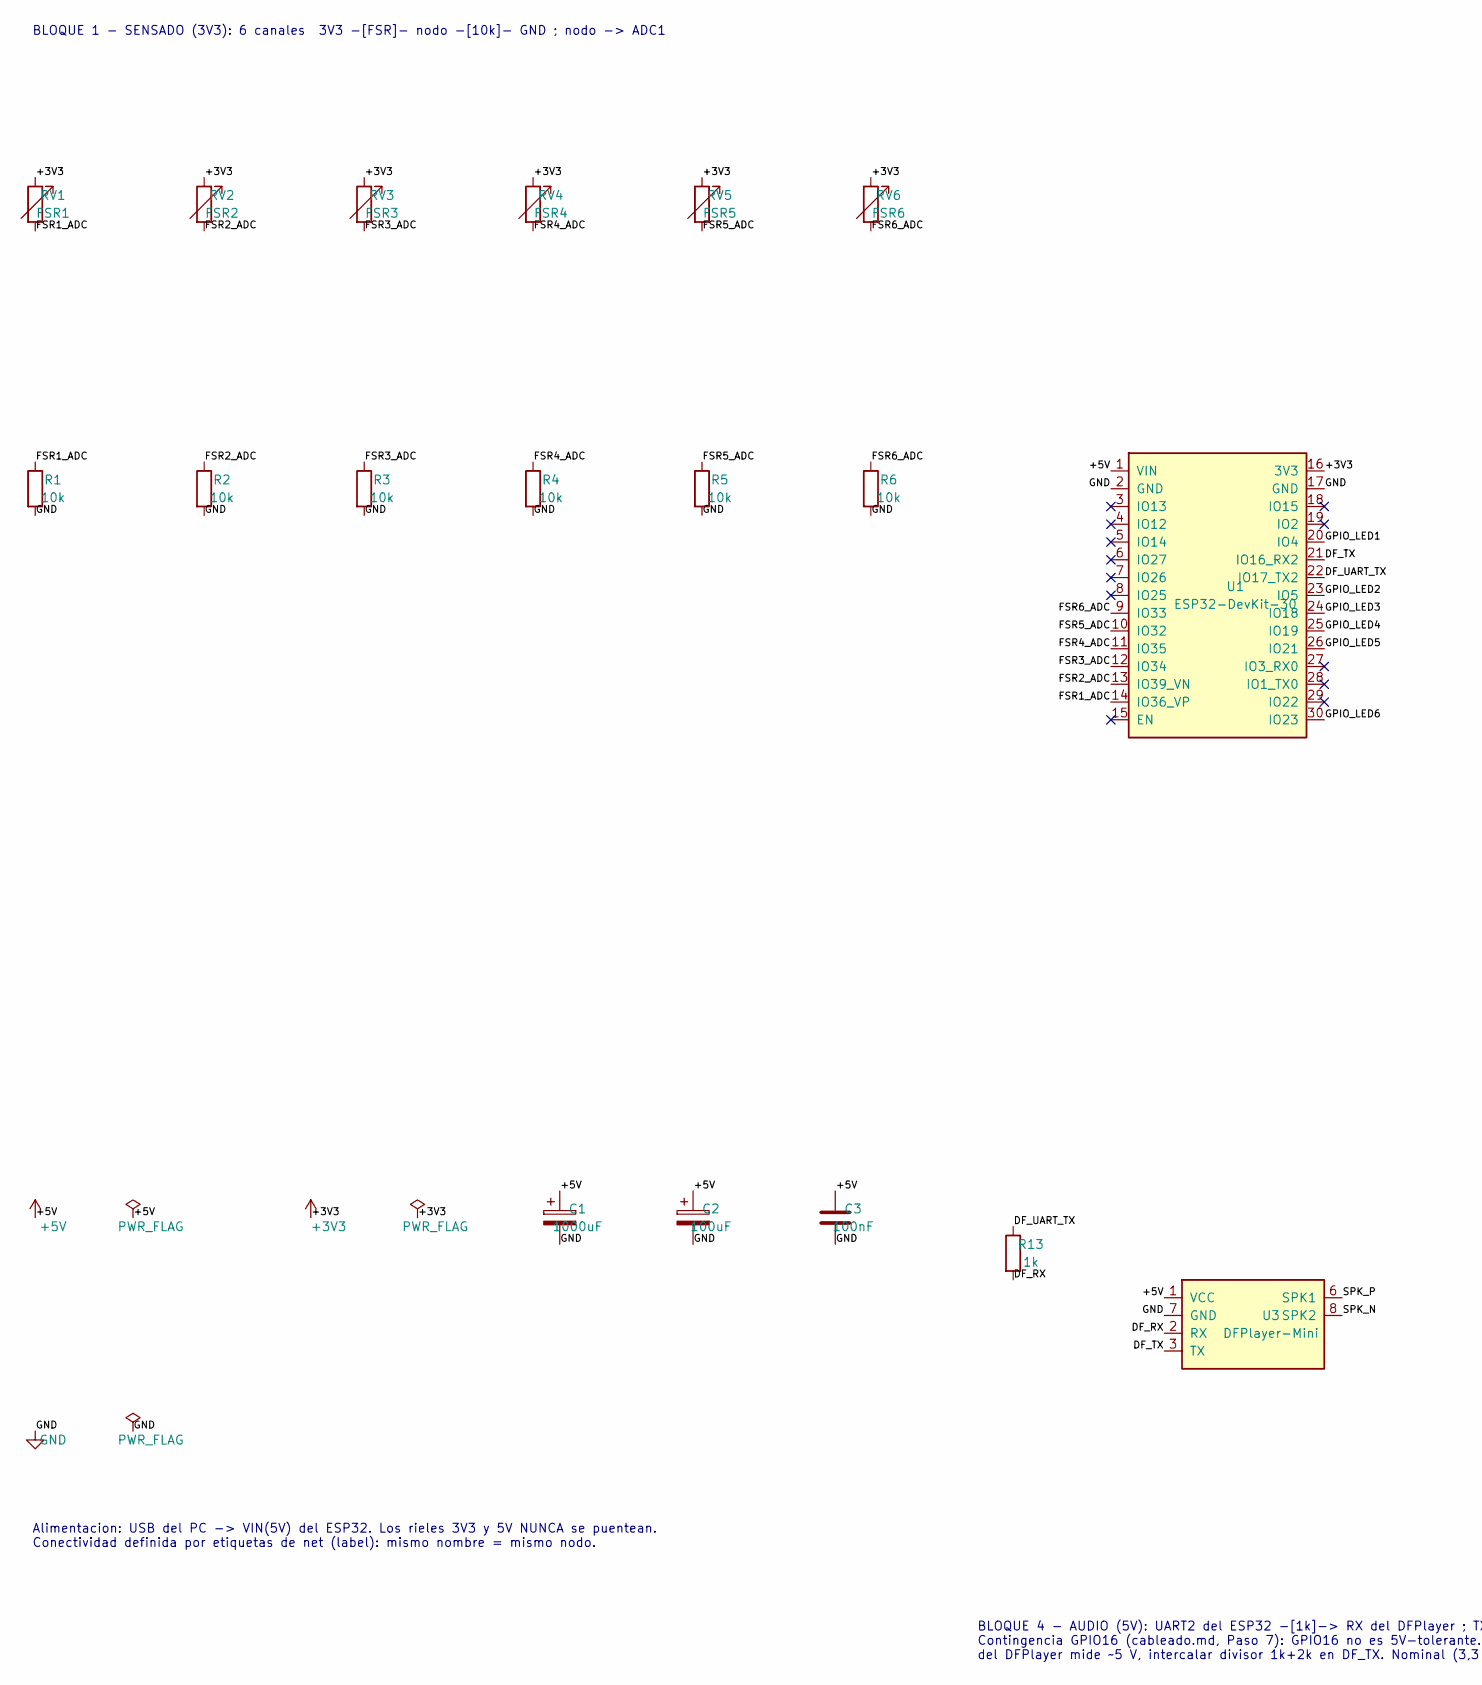
[picture p29: schematic tapete.kicad_sch, part in row 1, column 1]

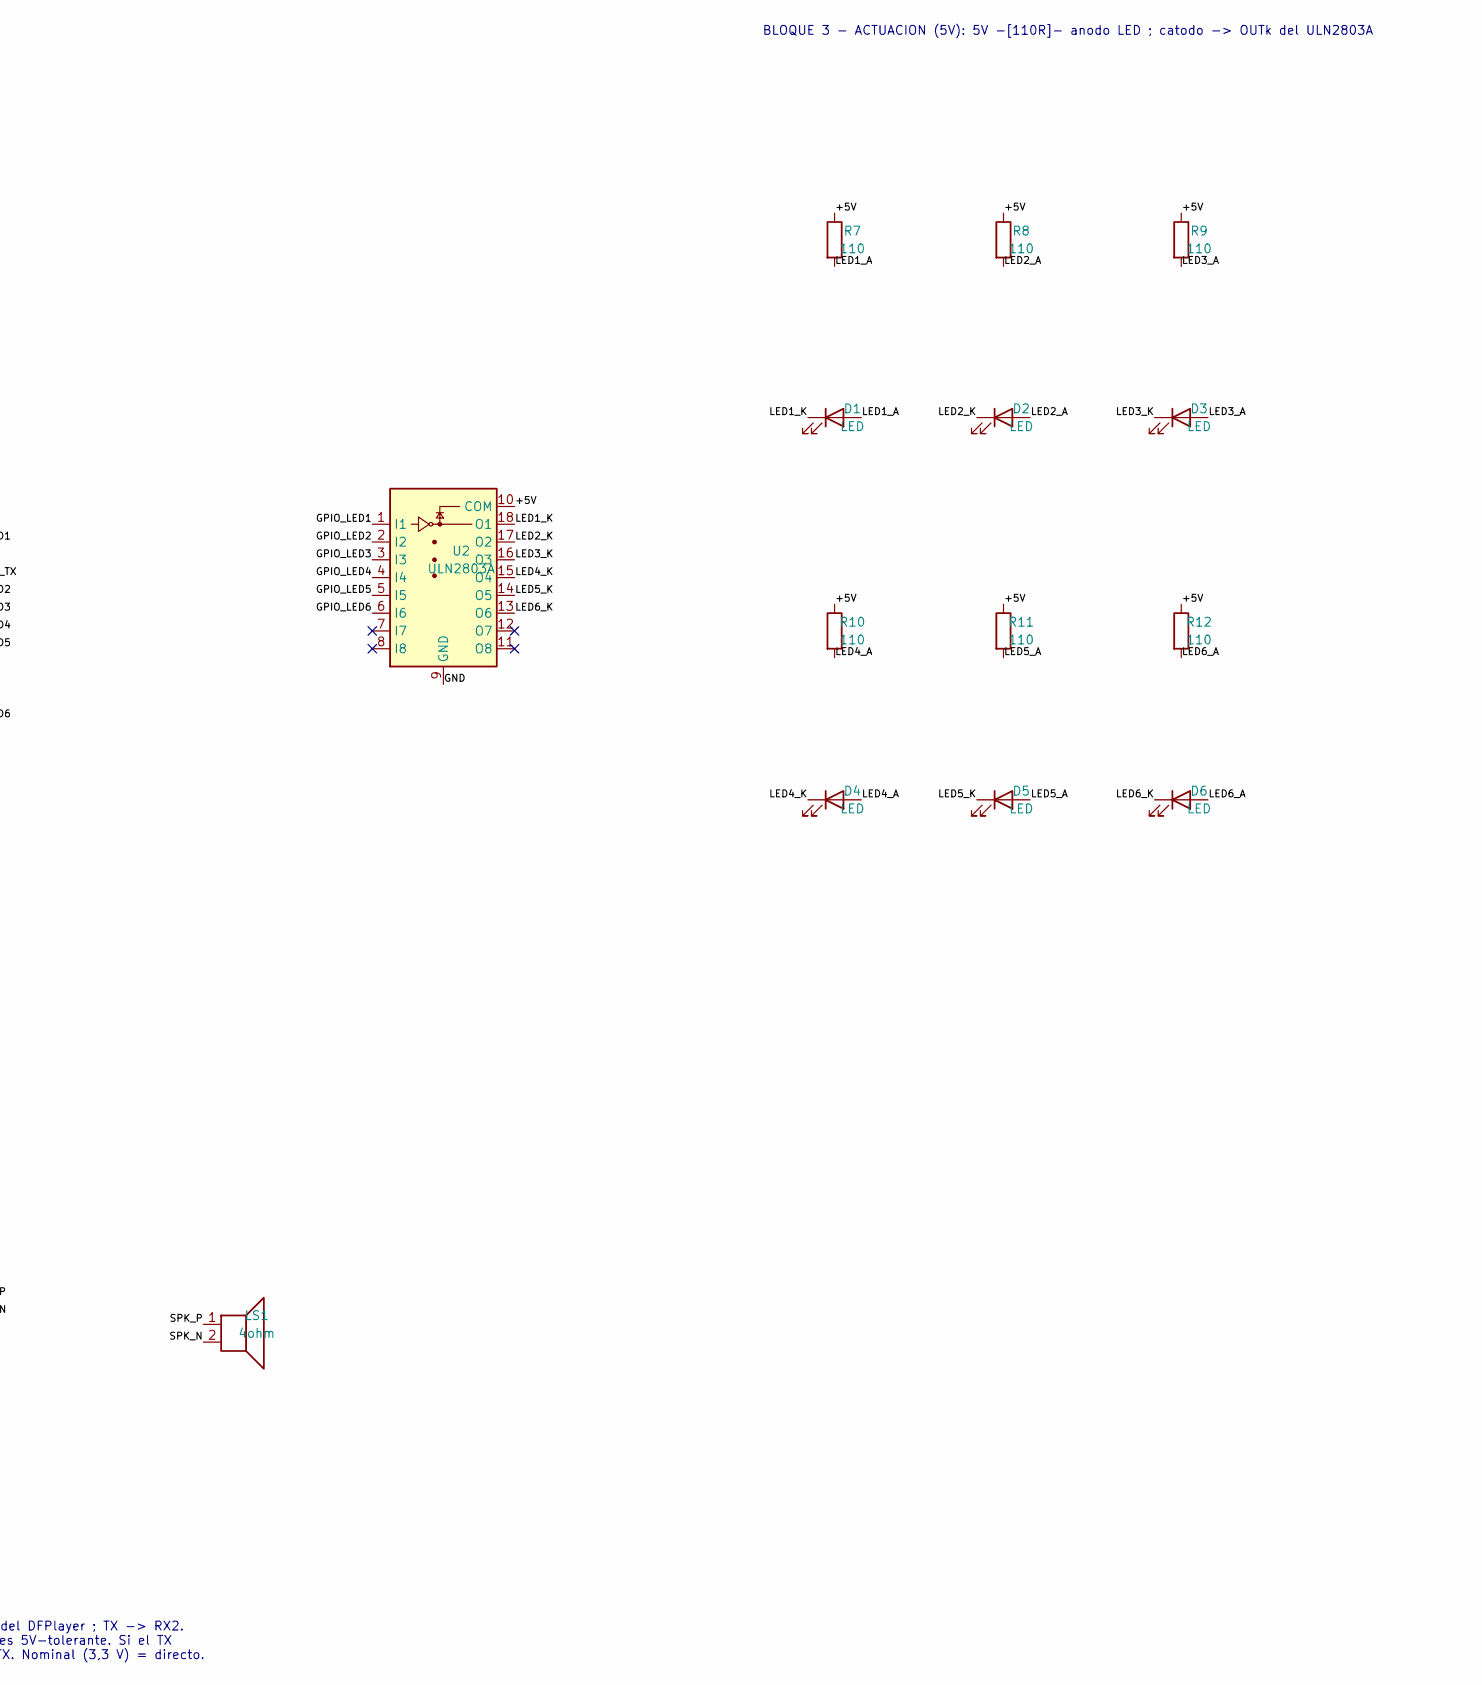
[picture p30: schematic tapete.kicad_sch, part in row 1, column 2]

Parts:
C1: 1000uF
C2: 100uF
C3: 100nF
D1, D2, D3, D4, D5, D6: LED
LS1: 4ohm
R1, R2, R3, R4, R5, R6: 10k
R7, R8, R9, R10, R11, R12: 110
R13: 1k
RV1: FSR1
RV2: FSR2
RV3: FSR3
RV4: FSR4
RV5: FSR5
RV6: FSR6
U1: ESP32-DevKit-30
U2: ULN2803A
U3: DFPlayer-Mini

Connections:
+3V3: RV1.1, RV2.1, RV3.1, RV4.1, RV5.1, RV6.1, U1.16 (3V3)
+5V: C1.1, C2.1, C3.1, R7.1, R8.1, R9.1, R10.1, R11.1, R12.1, U1.1 (VIN), U2.10 (COM), U3.1 (VCC)
DF_RX: R13.2, U3.2 (RX)
DF_TX: U1.21 (IO16_RX2), U3.3 (TX)
DF_UART_TX: R13.1, U1.22 (IO17_TX2)
FSR1_ADC: R1.1, RV1.2, U1.14 (IO36_VP)
FSR2_ADC: R2.1, RV2.2, U1.13 (IO39_VN)
FSR3_ADC: R3.1, RV3.2, U1.12 (IO34)
FSR4_ADC: R4.1, RV4.2, U1.11 (IO35)
FSR5_ADC: R5.1, RV5.2, U1.10 (IO32)
FSR6_ADC: R6.1, RV6.2, U1.9 (IO33)
GND: C1.2, C2.2, C3.2, R1.2, R2.2, R3.2, R4.2, R5.2, R6.2, U1.2 (GND), U1.17 (GND), U2.9 (GND), U3.7 (GND)
GPIO_LED1: U1.20 (IO4), U2.1 (I1)
GPIO_LED2: U1.23 (IO5), U2.2 (I2)
GPIO_LED3: U1.24 (IO18), U2.3 (I3)
GPIO_LED4: U1.25 (IO19), U2.4 (I4)
GPIO_LED5: U1.26 (IO21), U2.5 (I5)
GPIO_LED6: U1.30 (IO23), U2.6 (I6)
LED1_A: D1.2 (A), R7.2
LED1_K: D1.1 (K), U2.18 (O1)
LED2_A: D2.2 (A), R8.2
LED2_K: D2.1 (K), U2.17 (O2)
LED3_A: D3.2 (A), R9.2
LED3_K: D3.1 (K), U2.16 (O3)
LED4_A: D4.2 (A), R10.2
LED4_K: D4.1 (K), U2.15 (O4)
LED5_A: D5.2 (A), R11.2
LED5_K: D5.1 (K), U2.14 (O5)
LED6_A: D6.2 (A), R12.2
LED6_K: D6.1 (K), U2.13 (O6)
SPK_N: LS1.2, U3.8 (SPK2)
SPK_P: LS1.1, U3.6 (SPK1)

Notes on the sheet:
BLOQUE 1 - SENSADO (3V3): 6 canales 3V3 -[FSR]- nodo -[10k]- GND ; nodo -> ADC1
BLOQUE 3 - ACTUACION (5V): 5V -[110R]- anodo LED ; catodo -> OUTk del ULN2803A
Alimentacion: USB del PC -> VIN(5V) del ESP32. Los rieles 3V3 y 5V NUNCA se puentean. Conectividad definida por etiquetas de net (label): mismo nombre = mismo nodo.
BLOQUE 4 - AUDIO (5V): UART2 del ESP32 -[1k]-> RX del DFPlayer ; TX -> RX2. Contingencia GPIO16 (cableado.md, Paso 7): GPIO16 no es 5V-tolerante. Si el TX del DFPlayer mide ~5 V, intercalar divisor 1k+2k en DF_TX. Nominal (3,3 V) = directo.
