AlexisJ16/tapete_interactivo/firmware/test/test_modo_velocidad/test_modo_velocidad.cpp

// Tests del Modo 2 (Velocidad de reaccion, tipo "topo").
#define DOCTEST_CONFIG_IMPLEMENT_WITH_MAIN
#include "doctest.h"
#include "soporte_test.h"

using namespace proto;

// Arranca un motor en Modo Velocidad, nivel 1, semilla 12345.
// seed=12345 -> casillas objetivo [3,4,5,3,6,...].
static void arrancar(GameEngine& m) {
    m.procesar(Comando::parsear(R"({"cmd":"set_seed","seed":12345})"));
    m.procesar(Comando::parsear(R"({"cmd":"set_mode","mode":2,"level":1})"));
    m.procesar(Comando::parsear(R"({"cmd":"start"})"));
}

TEST_CASE("velocidad: dos aciertos consecutivos (coincide con golden)") {
    FakeHardware hw; Colector col;
    GameEngine motor(hw, col.sink());
    arrancar(motor);

    hw.reloj = 400; motor.pisar(3);
    hw.reloj = 900; motor.pisar(4);

    CHECK(subsecuencia(col.eventos, {
        Evento::state(2, "running"),
        Evento::led(3, 255),
        Evento::press(3, 400),
        Evento::score(2, 1, 0, 400, 1),
        Evento::led(4, 255),
        Evento::press(4, 900),
        Evento::score(2, 2, 0, 500, 2),
        Evento::led(5, 255),
    }));
}

TEST_CASE("velocidad: timeout cuenta como error y avanza") {
    FakeHardware hw; Colector col;
    GameEngine motor(hw, col.sink());
    arrancar(motor);

    hw.reloj = 5000; motor.actualizar();  // mas alla de la ventana (3000 ms en nivel 1)

    CHECK(subsecuencia(col.eventos, {
        Evento::state(2, "running"),
        Evento::led(3, 255),
        Evento::score(2, 0, 1, 0, 1),
        Evento::led(4, 255),
    }));
}

TEST_CASE("velocidad: pisar la casilla equivocada es un error") {
    FakeHardware hw; Colector col;
    GameEngine motor(hw, col.sink());
    arrancar(motor);

    hw.reloj = 200; motor.pisar(5);  // objetivo era 3

    CHECK(contiene(col.eventos, Evento::press(5, 200)));
    CHECK(contiene(col.eventos, Evento::score(2, 0, 1, 0, 1)));
    CHECK(contiene(col.eventos, Evento::led(4, 255)));  // pasa al siguiente objetivo
    CHECK(cuenta(col.eventos, Evento::Tipo::SOUND) == 1);  // solo INICIO: el error es mudo
}

TEST_CASE("velocidad: cada acierto suena ACIERTO; el error no suena") {
    FakeHardware hw; Colector col;
    GameEngine motor(hw, col.sink());
    arrancar(motor);                       // seed 12345, objetivo ronda1 = 3
    hw.reloj = 300; motor.pisar(3);        // acierto
    CHECK(contiene(col.eventos, Evento::sound(cfg::SONIDO_ACIERTO)));
    hw.reloj = 600; motor.pisar(1);        // error (objetivo era 4)
    CHECK(cuenta(col.eventos, Evento::Tipo::SOUND) == 2);  // INICIO + 1 ACIERTO
}

TEST_CASE("velocidad: termina tras completar todas las rondas (nivel 1 = 5)") {
    FakeHardware hw; Colector col;
    GameEngine motor(hw, col.sink());
    arrancar(motor);

    const int objetivos[5] = {3, 4, 5, 3, 6};  // seed 12345
    uint32_t t = 100;
    for (int i = 0; i < 5; ++i) {
        hw.reloj = t; motor.pisar(objetivos[i]); t += 300;
    }

    CHECK(motor.estado() == Estado::FINISHED);
    CHECK(contiene(col.eventos, Evento::state(2, "finished")));
    CHECK(contiene(col.eventos, Evento::score(2, 5, 0, 300, 5)));
}

TEST_CASE("velocidad: ping responde con hello") {
    FakeHardware hw; Colector col;
    GameEngine motor(hw, col.sink());
    motor.procesar(Comando::parsear(R"({"cmd":"ping"})"));
    CHECK(contiene(col.eventos, Evento::hello("1.0.0", 6)));
}

TEST_CASE("velocidad: la ronda siguiente usa la ventana del nuevo nivel") {
    FakeHardware hw; Colector col;
    GameEngine motor(hw, col.sink());
    arrancar(motor);                       // nivel 1: ventana 3000 ms
    hw.reloj = 100;
    motor.procesar(Comando::parsear(R"({"cmd":"set_level","level":3})")); // ventana 1200
    hw.reloj = 200; motor.pisar(3);        // acierto ronda1 -> ronda2 con ventana(3)=1200

    size_t antes = col.eventos.size();
    hw.reloj = 200 + 1199; motor.actualizar();
    CHECK(col.eventos.size() == antes);    // aun no expira (ventana 1200)
    hw.reloj = 200 + 1200; motor.actualizar();
    CHECK(contieneScore(col.eventos, 2, 1, 1, 2));  // timeout con la ventana nueva
}

TEST_CASE("velocidad: cambiar el nivel a mitad NO cambia el numero de rondas") {
    FakeHardware hw; Colector col;
    GameEngine motor(hw, col.sink());
    arrancar(motor);                       // nivel 1: 5 rondas; objetivos [3,4,5,3,6]
    const int obj[5] = {3, 4, 5, 3, 6};
    for (int i = 0; i < 5; ++i) {
        if (i == 1) motor.procesar(Comando::parsear(R"({"cmd":"set_level","level":4})"));
        hw.reloj = 100 * (i + 1); motor.pisar(obj[i]);
    }
    CHECK(motor.estado() == Estado::FINISHED);  // termina en 5 rondas (nivel 1), no 12
}

TEST_CASE("set_level en RUNNING no recrea el modo (conserva la ronda en curso)") {
    FakeHardware hw; Colector col;
    GameEngine motor(hw, col.sink());
    arrancar(motor);                       // modo 2, nivel 1, objetivo ronda1 = 3

    hw.reloj = 100;
    motor.procesar(Comando::parsear(R"({"cmd":"set_level","level":3})"));
    CHECK(motor.estado() == Estado::RUNNING);   // sigue corriendo (no reinicia)
    CHECK(motor.nivel() == 3);

    hw.reloj = 200; motor.pisar(3);        // si el modo sigue vivo, es un acierto
    CHECK(contieneScore(col.eventos, 2, 1, 0, 1));  // hit de la ronda 1
}
