AlexisJ16/tapete_interactivo/firmware/test/test_modo_equilibrio/test_modo_equilibrio.cpp

// Tests del Modo 3 (Equilibrio y coordinacion, patrones simultaneos).
#define DOCTEST_CONFIG_IMPLEMENT_WITH_MAIN
#include "doctest.h"
#include "soporte_test.h"

using namespace proto;

// seed=2024 -> casillas [3,6,5,4,6,2,5,1].
// Nivel 1: patrones de 2 casillas -> [3,6], [5,4], [6,2], [5,1]. 4 rondas.
static void arrancar(GameEngine& m) {
    m.procesar(Comando::parsear(R"({"cmd":"set_seed","seed":2024})"));
    m.procesar(Comando::parsear(R"({"cmd":"set_mode","mode":3,"level":1})"));
    m.procesar(Comando::parsear(R"({"cmd":"start"})"));
}

TEST_CASE("equilibrio: enciende un patron de 2 casillas") {
    FakeHardware hw; Colector col;
    GameEngine motor(hw, col.sink());
    arrancar(motor);
    CHECK(contiene(col.eventos, Evento::led(3, 255)));
    CHECK(contiene(col.eventos, Evento::led(6, 255)));
}

TEST_CASE("equilibrio: completar el patron es acierto y pasa al siguiente") {
    FakeHardware hw; Colector col;
    GameEngine motor(hw, col.sink());
    arrancar(motor);

    hw.reloj = 500;  motor.pisar(3);
    hw.reloj = 900;  motor.pisar(6);  // patron [3,6] completo

    CHECK(contiene(col.eventos, Evento::sound(cfg::SONIDO_RONDA)));
    CHECK(contieneScore(col.eventos, /*mode*/ 3, /*hits*/ 1, /*misses*/ 0, /*round*/ 1));
    // Siguiente patron [5,4]: aparece un LED nuevo.
    CHECK(contiene(col.eventos, Evento::led(5, 255)));
}

TEST_CASE("equilibrio: la pisada parcial es muda; completar suena RONDA") {
    FakeHardware hw; Colector col;
    GameEngine motor(hw, col.sink());
    arrancar(motor);                  // patron ronda1 = [3,6]
    hw.reloj = 500; motor.pisar(3);   // parcial: sin sonido
    CHECK(cuenta(col.eventos, Evento::Tipo::SOUND) == 1);  // solo INICIO
    hw.reloj = 900; motor.pisar(6);   // completa
    CHECK(contiene(col.eventos, Evento::sound(cfg::SONIDO_RONDA)));
}

TEST_CASE("equilibrio: pisar fuera del patron es error") {
    FakeHardware hw; Colector col;
    GameEngine motor(hw, col.sink());
    arrancar(motor);

    hw.reloj = 500; motor.pisar(1);  // 1 no esta en [3,6]

    CHECK(cuenta(col.eventos, Evento::Tipo::SOUND) == 1);  // solo INICIO: error mudo
    CHECK(contieneScore(col.eventos, 3, /*hits*/ 0, /*misses*/ 1, /*round*/ 1));
}

TEST_CASE("equilibrio: agotar el tiempo limite es error") {
    FakeHardware hw; Colector col;
    GameEngine motor(hw, col.sink());
    arrancar(motor);

    hw.reloj = 6000; motor.actualizar();  // limite nivel 1 = 5000 ms

    CHECK(cuenta(col.eventos, Evento::Tipo::SOUND) == 1);  // solo INICIO: timeout mudo
    CHECK(contieneScore(col.eventos, 3, 0, 1, 1));
}

TEST_CASE("equilibrio: termina tras completar todas las rondas (nivel 1 = 4)") {
    FakeHardware hw; Colector col;
    GameEngine motor(hw, col.sink());
    arrancar(motor);

    const int patrones[4][2] = {{3, 6}, {5, 4}, {6, 2}, {5, 1}};
    uint32_t t = 200;
    for (int r = 0; r < 4; ++r) {
        for (int i = 0; i < 2; ++i) {
            hw.reloj = t; motor.pisar(patrones[r][i]); t += 300;
        }
    }

    CHECK(motor.estado() == Estado::FINISHED);
    CHECK(contiene(col.eventos, Evento::state(3, "finished")));
}

TEST_CASE("equilibrio: la ronda siguiente usa el k del nuevo nivel") {
    FakeHardware hw; Colector col;
    GameEngine motor(hw, col.sink());
    motor.procesar(Comando::parsear(R"({"cmd":"set_seed","seed":2024})"));
    motor.procesar(Comando::parsear(R"({"cmd":"set_mode","mode":3,"level":1})")); // k=2
    motor.procesar(Comando::parsear(R"({"cmd":"start"})"));
    // patron ronda1 (k=2) = [3,6]. Subir a nivel 2 (k=3) en RUNNING.
    hw.reloj = 100;
    motor.procesar(Comando::parsear(R"({"cmd":"set_level","level":2})"));
    size_t base = col.eventos.size();
    hw.reloj = 150; motor.pisar(3);
    hw.reloj = 200; motor.pisar(6);        // completa ronda1 -> nuevoPatron ronda2 (k=3)
    int encendidos = 0;
    for (size_t i = base; i < col.eventos.size(); ++i)
        if (col.eventos[i].tipo == Evento::Tipo::LED && col.eventos[i].level == 255)
            ++encendidos;
    CHECK(encendidos == 3);                // 3 casillas = k del nivel 2
}

TEST_CASE("regresion: set_mode durante una sesion la detiene sin corromper LEDs") {
    // El monkey de robustez cambiaba de modo a mitad de sesion: SET_MODE creaba el
    // modo nuevo pero NO lo iniciaba ni tocaba el estado, dejandolo en RUNNING con
    // patron_/enPatron_ sin inicializar. El siguiente actualizar() disparaba
    // fallar()->apagarPatron() sobre memoria basura -> led con celda corrupta ->
    // IndexError en el dashboard -> crash de Qt.
    FakeHardware hw; Colector col;
    GameEngine motor(hw, col.sink());
    motor.procesar(Comando::parsear(R"({"cmd":"set_seed","seed":2024})"));
    motor.procesar(Comando::parsear(R"({"cmd":"set_mode","mode":2,"level":1})"));
    motor.procesar(Comando::parsear(R"({"cmd":"start"})"));
    REQUIRE(motor.estado() == Estado::RUNNING);

    // Cambiar de modo a mitad de sesion.
    motor.procesar(Comando::parsear(R"({"cmd":"set_mode","mode":3,"level":4})"));
    // El motor queda en un estado seguro (IDLE), no RUNNING con un modo sin iniciar.
    CHECK(motor.estado() == Estado::IDLE);

    // Avanzar el reloj y actualizar no debe emitir ningun LED con celda invalida.
    hw.reloj = 100000; motor.actualizar();
    for (const auto& e : col.eventos) {
        if (e.tipo == Evento::Tipo::LED) {
            CHECK(e.cell >= 1);
            CHECK(e.cell <= cfg::CELDAS);
        }
    }
}
