AlexisJ16/tapete_interactivo/(commit log)

2026-06-04 Fase 1: andamiaje del proyecto
    - Estructura de carpetas (firmware/simulator/dashboard/shared/audio/docs/scripts)
    - platformio.ini con envs esp32dev (real) + native
    - shared/protocol.md: protocolo JSON v1.0.0 (eventos/comandos, mini-serializador, RNG xorshift32)
    - shared/golden_vectors.json: esquema + 2 escenarios semilla (modo Velocidad)
    - scripts/run_all_tests.sh: runner unico (doctest C++ + pytest), reporta verde/rojo
    - requirements de Python, README inicial, .gitignore
    - venv con pytest
2026-06-04 Fase 2: GameCore (logica portable) + tests test-first
    - Rng.h: xorshift32 determinista y seedable (base de golden vectors)
    - Protocol.{h,cpp}: eventos/comandos, mini-parser JSON propio, round-trip
    - IHardware.h, Motor.h: interfaces de hardware y servicios para los modos
    - GameEngine.{h,cpp}: maquina de estados no bloqueante, dirigida por hw.millis()
    - modes/ModoMemoria, ModoVelocidad, ModoEquilibrio
    - Tests doctest (TDD): RNG, protocolo y los 3 modos -> 26 casos, ~2099 aserciones, verde
    - Fix run_all_tests.sh: rutas relativas (la ruta del proyecto tiene un espacio)
    [test_modo_equilibrio.cpp, test_modo_memoria.cpp, test_modo_velocidad.cpp, test_rng.cpp]
2026-06-04 Fase 3: simulador visual (Pygame) + puente ctypes + golden runner
    - firmware/lib/GameCore/bridge.cpp: C ABI sobre GameEngine (el .so = ESP32 en software)
    - simulator/core_bridge.py: carga GameCore.so via ctypes + auto-build con g++
    - simulator/golden_runner.py + test_golden.py: replay de golden_vectors.json contra el .so
    (valida C++ y simulador a la vez: una sola implementacion)
    - shared/golden_vectors.json: +escenario strict (stream exacto auditado)
    - simulator/tapete_sim.py: ventana 2x3, clic=pisada, LEDs blancos (brillo PWM), audio MP3
    opcional; modo --smoke headless. test_sim_smoke.py valida el flujo sin pantalla.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
2026-06-04 Fase 4: dashboard del terapeuta (PyQt6 + SQLite) + integracion
    - dashboard/storage.py: persistencia SQLite (perfiles, sesiones, eventos)
    - dashboard/fuente.py: FuenteCore (GameCore.so en proceso) y FuenteTCP (ESP32/red)
    - dashboard/sesion.py: controlador headless (calcula metricas y persiste)
    - dashboard/reports.py: export CSV y PDF (matplotlib, backend Agg)
    - dashboard/app.py: GUI PyQt6 (LEDs blancos, control modo/nivel/perfil, reportes)
    - simulator/servidor.py: servidor TCP del simulador (mismo protocolo que el ESP32)
    - Tests pytest: storage, integracion punta a punta (SQLite+CSV, §10.3), TCP
    (criterio 5), reportes, y smokes headless de simulador y GUI. Total 14 verde.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
2026-06-04 Fase 6: documentacion completa
    - docs/wiring.md: mapa de pines, protoboard, divisor FSR 10k, LEDs a 5V, DFPlayer
    - docs/flashing.md: flasheo, WiFi (secrets.h), calibracion del umbral
    - docs/validation.md: como correr simulador, dashboard y todos los tests
    - audio/README.md: MP3 esperados en la microSD
    - README.md: comandos exactos (tests, simulador, dashboard, flasheo) y protocolo
2026-06-04 Fase 5: firmware ESP32 (EspHardware + WiFi/TCP) — compila para esp32dev
    - src/EspHardware.{h,cpp}: drivers reales FSR(ADC)/LED(LEDC)/DFPlayer.
    LEDC compatible con Arduino-ESP32 2.x (por canal) y 3.x (por pin).
    - src/main.cpp: WiFi + servidor TCP 3333, deteccion de pisadas (FSR+antirrebote),
    integracion con GameEngine. Emite/recibe el mismo protocolo por TCP y Serial.
    - src/secrets.h.example: plantilla de credenciales WiFi (secrets.h en .gitignore).
    - Verificado: 'pio run -e esp32dev' = SUCCESS (RAM 13.8%, Flash 60.0%).
2026-06-04 Cierre: golden de los 3 modos por el .so + audio fiable (playMp3Folder)
    - shared/golden_vectors.json: +memoria_juego_completo (seed 777) y
    +equilibrio_juego_completo (seed 2024). Antes solo Velocidad cruzaba el puente
    ctypes; ahora los 3 modos se validan de punta a punta por el .so (criterio 1),
    incluida la fase de exhibicion temporizada de Memoria.
    - EspHardware: reproducirSonido usa playMp3Folder(id) (fiable por numero) en vez
    de play(id) (depende del orden de copiado en la SD).
    - docs/audio: los MP3 del ESP32 van en /mp3/000X.mp3.
    Verificado: pio run -e esp32dev SUCCESS; run_all_tests.sh TODO VERDE (16 pytest).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
2026-06-04 Anade scripts/demo_visual.py: genera capturas/GIF del simulador y dashboard
    Renderiza estados reales de juego a PNG (headless) y arma un GIF del simulador.
    Util como evidencia visual y para CI. Usa subprocess (no shell) para ffmpeg.
2026-06-04 Cierre de sesion: CLAUDE.md de proyecto + docs/ROADMAP.md
    - CLAUDE.md: guia para Claude (principio rector, estado verde, comandos clave,
    convenciones, trampas conocidas, estructura) para arrancar nuevas sesiones.
    - docs/ROADMAP.md: proximos pasos (hardware fisico, mejoras de modos/dashboard,
    CI, golden vectors) para continuar el desarrollo.
2026-06-04 SP1: spec de diseño de lógica adaptable (recomendación asistida)
    Brainstorming de SP1 (primero de 4 sub-proyectos del plan de mejora hacia
    proyecto de grado de excelencia). Diseño aprobado:
    - Adaptación asistida (human-in-the-loop): el sistema sugiere, el terapeuta aplica.
    - Evaluación en vivo tras cada ronda; regla de tasa en ventana móvil + histéresis.
    - Refactor de nivel dinámico por ronda (aplica sin reiniciar la sesión).
    - Evento de protocolo `suggest` con rate/window.
    - Estrategia TDD + golden vectors y sección de oportunidades de mejora diferidas.
2026-06-04 SP1: spec validada/amendada + plan de implementacion TDD
    Validacion profunda contra el codigo real (bitacora 10 de la spec): rate del evento suggest = entero porcentaje (protocolo entero-o-cadena); dir keep al saturar; histeresis = banda muerta (evaluar puro) + de-dup en GameEngine; acierto = delta-hits. Plan TDD de 10 tasks en docs/superpowers/plans/.
2026-06-05 Higiene: CLAUDE.md alineado con estado real + plan SP1 tareas 1-2 marcadas
    - CLAUDE.md: conteo correcto (34 casos C++ / ~2118 aserciones / 16 pytest)
    - CLAUDE.md: elimina regla de idioma (redundante con ~/.claude/rules/communication.md)
    - plan SP1: Tasks 1 y 2 marcadas [x] con evidencia de commit (b8e8131, 1b1b14e)
    - auditorias/higiene-2026-06-05: reporte de rúbrica con 2 AUTO-FIX + 3 FLAGS
2026-06-08 SP1: evento de protocolo suggest (rate entero %, sin floats)
2026-06-08 SP1: GameEngine consulta al Recomendador y emite suggest (de-dup)
2026-06-08 SP1: set_level en RUNNING no recrea el modo (fix bug latente)
    [test_modo_velocidad.cpp]
2026-06-08 SP1: golden vectors de suggest (up/down) y set_level strict
2026-06-08 SP1: documenta el evento suggest en protocol.md
2026-06-08 Docs: diagrama de conexiones HTML + simulacion Wokwi + fotos hardware
2026-06-08 Diagrama: rediseño completo — CSS pinout + SVGs enfocados + sin solapamientos
    Reescritura total de docs/diagrama-conexiones.html. El diagrama SVG
    monolítico con coordenadas absolutas causaba texto superpuesto y líneas
    cruzadas ilegibles. El nuevo diseño usa:
    - Vista de pines ESP32 en CSS flexbox (no SVG): etiquetas coloreadas por
    función (FSR=morado, LED=verde, DFPlayer=naranja, GND/3V3/VIN con badges).
    - Dos SVGs pequeños y enfocados: uno para el circuito FSR (divisor de
    voltaje con pull-down 10kΩ) y otro para el grupo LED (3 en paralelo con
    110Ω en serie).
    - Cuatro tablas HTML limpias: FSR, LED, DFPlayer, rieles de alimentación.
    - Secuencia de armado de 11 pasos con estil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
2026-06-08 Higiene de cierre: conteos de tests + punto de entrada SP2
    - CLAUDE.md: corrige conteo de tests a 43 casos C++ / 2134 aserciones + 21 pytest
    (SP1 agregó test_adaptacion.cpp); añade diagrama-conexiones.html a la estructura.
    - docs/ROADMAP.md: añade nota de continuación SP2; actualiza referencia de montaje
    a docs/diagrama-conexiones.html como guía visual principal.
2026-06-10 docs: corregir ruta (Documentos→code/) y actualizar estado en CLAUDE.md
    Recorte de optimización del ecosistema Claude Code (s36): corrige la
    ruta obsoleta del proyecto y refresca el estado vigente (SP1 completo).
2026-06-22 SP1: valida, marca y archiva el plan + spec (todo verde)
    Valida empiricamente las 10 tasks de SP1: los commits d475553..d4fe38c
    existen y tocan los archivos que cada Task declara; la suite corre verde
    hoy (C++ 43 casos/2134 aserciones + pytest 21 passed + pio run -e esp32dev
    SUCCESS). Marca los 54 steps con evidencia (cuadro Task->commit->test +
    sello por Task) y archiva el plan junto a su spec de diseno en
    docs/superpowers/{plans,specs}/archive/. Anade el reporte de higiene del
    ecosistema (4 memorias clasificadas, ruta/inventario corregidos).
2026-06-22 scripts: captura platformio en requirements + runner falla sin pytest
    run_all_tests.sh daba falso-verde: si pytest no estaba disponible solo
    emitia un AVISO y aun asi imprimia TODO VERDE, ocultando que los tests
    Python no corrieron. Ahora invoca .venv/bin/python -m pytest (robusto a
    mudanzas de ruta, no depende de activate ni de los console scripts) y
    marca ROJO + exit 1 si los tests Python no corren. platformio se anade a
    requirements-dev.txt (no estaba capturado; recrear el venv perdia pio).
    Test de regresion: scripts/test_runner_pytest_guard.sh.
2026-06-24 Higiene pre-merge: corrige conteo de aserciones + reubica assets de la raiz
    - CLAUDE.md L18: ~2118 -> ~2134 aserciones (alinea con L24, valor real verificado)
    - docs/assets/: 3 fotos de hardware (FotoESP32, Protoboard, EspacioESP32enProtoboard)
    - docs/: anteproyecto V3 + articulo (.docx) fuera de la raiz
    Suite verde sobre el arbol reorganizado (43 casos / 2134 aserciones C++ + 21 pytest);
    pio run -e esp32dev SUCCESS. Sin cambios de codigo funcional.
2026-06-24 docs: cierra SP1 en ROADMAP (merge a main + materiales en mano)
    - PUNTO DE CONTINUACIÓN: SP1 mergeado a main (4cf3543), no 'lista para merge'
    - §1 hardware: 6×10kΩ marcadas como conseguidas (2026-06-22); microSD en mano, falta grabarla
2026-06-24 SP2: spec de cierre 1-jul (SP2 mínimo demostrable + documento honesto)
    Reencuadre por deadline 2026-07-01 (proyecto de grado completo). SP2 software
    recortado a: generador de evidencia + analítica/figuras + reconexión TCP. Plan de
    7 días en dos carriles; integridad: validación de banco, no clínica; RGB→blanco.
2026-06-24 SP2: plan de implementación del generador de evidencia (Velocidad, E1-E4)
    Código validado contra el .so en spike: jugador determinista perfecto→suggest up,
    pésimo→down. Núcleo Velocidad; Memoria/Equilibrio y banco (E5/E6) en incrementos
    posteriores.
2026-06-24 SP2: jugador simulado determinista para Velocidad (E1/E2)
    Reacciona a los eventos led contra el .so; dado xorshift32 propio en [0,1).
    Tests: determinismo + perfecto→suggest up + pésimo→suggest down.
2026-06-24 SP2: agregación de evidencia (barridos habilidad/nivel + trayectoria)
    barrido_habilidad/barrido_niveles/trayectoria_adaptativa, deterministas sobre el
    jugador simulado. Verificado: hábil sube 1→4, con dificultad baja 4→1.
2026-06-24 SP2: figuras de evidencia E2/E3/E4 (generador CLI, etiquetadas como simulación)
    Cada figura hornea la nota 'simulación determinista — no datos de usuarios reales'
    (integridad académica). E2 adaptación, E3 desempeño por nivel, E4 trayectoria.
    Suite: 43 casos C++ + 28 pytest, TODO VERDE.
2026-06-24 SP2/SP4: borrador honesto del artículo (validación de banco, no clínica)
    Reencuadra el artículo de 'evaluación con pacientes realizada' (falso:
    fundación, comité de ética, entrevistas, placeholders [N]/[X]) a validación
    funcional honesta: simulación determinista E1-E4 con cifras reales
    (reproducibles, semilla 777) + E5/E6 de banco marcadas como pendientes.
    Corrige RGB->blanco PWM como decisión de ingeniería justificada (§4.1) y
    añade tabla de trazabilidad objetivo->evidencia. Cifras solo de E1-E4;
    sin afirmaciones clínicas no realizadas. docx generado con pandoc.
    Nota de revisión en articulo_honesto_CAMBIOS.md.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
2026-06-24 SP2-C: reconexión automática en FuenteTCP (robustez de demo)
    Si el ESP32 cae estando conectado, FuenteTCP reconecta sola: el socket caído
    se marca y los siguientes enviar()/recibir() reintentan con backoff exponencial
    acotado, no bloqueante (no traba la UI). El primer intento sigue propagando
    (fallar ruidoso si la IP es errónea al arrancar). Contrato Fuente intacto.
    TDD: servidor de prueba que cae y revive; enviar() sobre socket muerto no lanza.
    Suite: 43 casos C++ + 30 pytest, TODO VERDE.
2026-06-24 SP2: corrige integridad del borrador — banco (E5/E6) NO dado por hecho
    El Resumen/Abstract y §6 afirmaban en pasado pruebas de banco y latencia que
    no existen (HW sin montar), contradiciendo §5.5. Ahora: lo realizado es solo
    la simulación determinista (E1-E4); el banco queda como continuación/pendiente
    de forma consistente en todo el documento (§4.4 'por obtener', no 'obtenidas').
    §5.3 atribuye el error al jugador simulado, no al sistema. §6 suaviza 'viable'.
    docx regenerado. Además: documenta en FuenteTCP que la reconexión es solo de
    transporte (no re-sincroniza modo/nivel).
    [fuente.py]
2026-06-24 SP2-B: analítica embebida en el dashboard (histórico por perfil)
    Nueva pestaña 'Analitica' en app.py con matplotlib embebido (FigureCanvasQTAgg):
    evolución de aciertos/errores, tiempo de respuesta y adaptación acierto-vs-nivel
    por perfil, sobre el histórico real de SQLite. Botón exportar PNG.
    - analitica.py: agregación PURA (serie_evolucion/tasa_acierto) — LEE de storage,
    no duplica lógica de GameCore. TDD en test_analitica.py.
    - PanelAnalitica (app.py): widget headless-testeable; smoke + integración
    end-to-end (jugar en el dashboard -> aparece en su analítica) en
    test_analitica_widget.py. Una sola fuente de verdad.
    Trampa resuelta: el FigureCanvas aborta si el QApplicat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
    [analitica.py, app.py, test_analitica.py, test_analitica_widget.py]
2026-06-24 SP2/SP4: trazabilidad anteproyecto-guía -> artículo (material de sustentación)
    El anteproyecto V3 es la GUÍA del profesor (se conserva sin cambios); el artículo
    es el entregable. Mapea pregunta de investigación + objetivo general + 3 específicos
    -> cómo los aborda el artículo, con las 2 desviaciones justificadas (RGB->blanco;
    evaluación terapéutica real -> validación funcional + trabajo futuro) y el argumento
    de defensa de cada una. Punto sensible de sustentación: alcance del objetivo (iii).
2026-06-29 HW: diseño de circuito completo (esquemático, protoboard, físico)
    Diseño de hardware del tapete (6 botones FSR + LEDs, ULN2803A):
    - docs/hardware/: esquemático, protoboard, plano físico (SVG), guía
    Fritzing, diseño de circuito y README.
    - docs/DiseñoProtoboard.html/.ods: hoja de diseño del protoboard.
    [DiseñoProtoboard.ods]
2026-06-29 docs: fotos de la caja física como evidencia de montaje
    4 fotos (caja 40×28×13 cm) en docs/evidencia/caja/: vista frontal,
    caja y tapa, tapa puesta. Evidencia del avance de armado físico.
2026-06-29 docs: depura andamiaje, consolida el artículo y reorganiza en subcarpetas
    Higiene profunda de la documentación (lente: repo de desarrollo; código intacto):
    - Depura andamiaje de proceso: borra docs/superpowers/, articulo_honesto_CAMBIOS,
    trazabilidad_anteproyecto_articulo y la Especificación maestra (raíz).
    - Borra docs/assets/*.jpeg (huérfanas, sin referencias).
    - Consolida el artículo en UNA versión: articulo_honesto_borrador ->
    docs/articulo/Articulo_Tapete_Interactivo.{md,docx} (contenido honesto vigente:
    LED blanco PWM, validación de banco). Elimina la versión vieja aspiracional (RGB).
    - Reorganiza docs/ en subcarpetas: articulo/ (artículo + anteproyecto V3),
    hardwar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
    [DiseñoProtoboard.ods]
2026-06-29 docs: elimina diagrama-conexiones.html (obsoleto frente al plano exacto del protoboard)
    El diagrama era de la versión previa (2026-06-08), anterior al plano exacto del
    usuario. Su contenido (pines ESP32, FSR/LED/DFPlayer, rieles, secuencia de armado)
    está cubierto con mayor precisión por docs/hardware/00_diseno_circuito.md + planos SVG.
    Se reescribe la referencia del ROADMAP hacia ese paquete. Sin rastros restantes.
2026-06-29 docs: corrige conteo de pytest en CLAUDE.md (21 -> 36, real)
    El run_all_tests.sh reporta 36 pytest (no 21); el conteo quedó desactualizado tras
    los incrementos SP2 (analítica, reconexión, jugador_sim). C++ 43/2134 sí es correcto.
2026-06-29 docs(roadmap): alinea el checklist de LEDs a ULN2803A (decisión del maestro)
    El paquete maestro 00_diseno_circuito.md ya fijó 1× ULN2803A; el checklist del
    ROADMAP ofrecía aún '2N2222 o ULN2803'. Se elimina la disyuntiva para cero
    ambigüedad en el montaje. wiring.md conserva la explicación conceptual del driver.
2026-06-30 chore: poda andamiaje huérfano y corrige desactualizaciones en docs
    - Elimina wokwi/ (smoke test de pines huérfano, no referenciado por ninguna doc
    ni por run_all_tests; no demuestra la lógica del juego — la fuente de verdad
    es firmware/).
    - Elimina auditorias/ (reportes de higiene de memoria de sesiones pasadas;
    proceso interno, no producto).
    - README/wiring: corrige hardware desactualizado — sin parlante (build por
    presupuesto), LEDs a 5 V vía 1× ULN2803A, 10× 110 Ω (1 por grupo), y apunta
    al documento maestro 00_diseno_circuito.md (jerarquía de planos correcta).
    Suite TODO VERDE (43 casos C++ / 2134 aserciones + 36 pytest).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
2026-06-30 HW: mapa de armado del protoboard como hoja de cálculo exacta (v1)
    Plano de montaje hueco-por-hueco en docs/hardware/mapa_armado_protoboard.xlsx
    (generador reproducible generar_mapa_armado.py, Python + openpyxl), derivado de la
    geometría real validada con el autor (ESP32 cols 22-41, pines 25-39, USB-C col 21
    filas F-G, zonas libres 1-21 y 42-64) + firmware Config.h. Reemplaza el enfoque SVG
    previo, que alucinaba columnas (ponía el ESP32 en 24-38).
    Hoja 1 (protoboard): ESP32, 6 divisores FSR (cols 1-21 sup), ULN2803A (cols 51-59)
    + 6 grupos LED con par ánodo/cátodo juntos (cols 1-21 inf), DFPlayer como bloque
    (pinout PENDIENTE de verificar en el módulo físico), rieles y USB-C. Hoja 2: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
    [mapa_armado_protoboard.xlsx]
2026-07-02 docs(hardware): reorganiza a materiales.md + cableado.md y sincroniza el inventario real
    - Nuevos: materiales.md (BOM + tabla de presupuesto) y cableado.md (geometria
    del protoboard cols 25-39, net list verificado contra Config.h, ruteo de la
    Fila J, leyenda, checklist con multimetro). cableado.md reemplaza el .xlsx.
    - 00_diseno_circuito.md reescrito como documento de diseno (decisiones, potencia,
    prototipo fisico con refuerzos de acrilico).
    - Borrados obsoletos/redundantes: wiring.md, guia-fritzing.md, el .xlsx y su
    generador .py (los SVG y DisenoProtoboard ya estaban borrados).
    - Sincronizado en todo el repo: parlante 4 ohm (antes 'sin parlante'), resistencias
    reales (sin 110 ohm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
    [DiseñoProtoboard.ods, mapa_armado_protoboard.xlsx]
2026-07-02 docs(hw): alinea grupos LED a 2.2 kΩ (materiales.md = fuente de verdad) + spec/plan setup ingeniería
    Poda Fase 0: las 6 resistencias de grupo LED pasan de 1 kΩ a 2.2 kΩ (las 2× 1 kΩ
    del inventario están asignadas al DFPlayer y al divisor GPIO16). Alinea cableado.md,
    00_diseno_circuito.md, materiales.md, ROADMAP.md y README.md a materiales.md como
    fuente única. Añade el spec y el plan del epic de setup de ingeniería.
2026-07-02 chore(cc): Fase 1 gobernanza — hook guard-flash + permisos + disciplina hardware + pio canónico
    Protege el ESP32 único: .claude/hooks/guard-flash.sh (PreToolUse/Bash, exit 2)
    bloquea flasheo/serial (upload/esptool/device monitor/dev/tty), unit-testeado
    (9 seguros->0, 6 flasheo->2). .claude/settings.json: permisos allow (compilar/
    tests/ngspice/kicad-cli/wokwi-cli) + deny (upload/esptool/rm -rf). Bloque de
    disciplina de hardware en CLAUDE.md con SoT corregida (cableado.md + Config.h,
    conciliar en conflicto). scripts/pio = wrapper canónico de .venv/bin/pio 6.1.19.
2026-07-02 feat(hw): Fase 2 ngspice — valida divisor FSR y grupo LED con valores reales
    divisor_fsr.cir: barrido R_FSR (250 ohm..10 Mohm) sobre pull-down 10k. Confirma
    separacion limpia reposo(~4-40 cuentas) vs pisada(>2700) y que UMBRAL_PISADA=2000
    cae en R_FSR~10k (bien ubicado; afinar en hardware). grupo_led.cir: 3 LED blancos
    en paralelo con Rg=2.2k + V_CE(sat)=0.9V -> ~0.19 mA/LED, 0.58 mA/grupo, ~3.5 mA
    los 6 grupos (USB sobra; brillo muy tenue, limite del inventario). Resultados y
    conclusiones en spice/README.md.
2026-07-02 docs(plan): Fase 3 KiCad — método de esquemático (símbolos tipados + power flags, ERC significativo, build incremental)
2026-07-02 feat(hw): Fase 3 KiCad — esquemático completo, ERC significativo 0/0/0, exports
    Autoría programática del esquemático (docs/hardware/kicad/) con símbolos TIPADOS
    y ERC significativo (validado rojo→verde). Cruza net-por-net con cableado.md/Config.h.
    - Motor kisch.py: emite .kicad_sch v10 genuino (kicad-cli sch upgrade idempotente);
    UUIDs deterministas; punto_conexion con Y-flip símbolo→esquemático (Sx+px, Sy−py)
    — bug de conectividad cazado por el netlist en el walking skeleton.
    - gen_tapete.py: build INCREMENTAL (esp32→fsr→uln→dfplayer). Símbolos custom
    ESP32-DevKit-30 y DFPlayer-Mini (power_in/input/output/bidirectional tipados);
    ULN2803A/R/LED/C/Speaker stoc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
    [tapete-bom.csv, tapete.kicad_sch]
2026-07-02 feat(hw): Fase 4 Wokwi — wokwi.toml + diagram.json mínimo, smoke test verde
    Config de Wokwi CLI para simular el firmware real (entorno esp32dev):
    - wokwi.toml apunta a los artefactos de PlatformIO (.pio/build/esp32dev/).
    - diagram.json mínimo: placa wokwi-esp32-devkit-v1 + monitor serial (humo
    de arranque; el cableado FSR/LED/DFPlayer se añade guiado después).
    Smoke test validado LIVE:
    wokwi-cli firmware --timeout 20000 --expect-text "Tapete Interactivo"
    La simulación arranca el firmware y encuentra el banner de boot en el serial
    ("Tapete Interactivo — firmware 1.0.0", main.cpp:106, previo al WiFi) → TEST PASSED.
    Nota de red (config LOCAL, no del repo): la ruta IPv6 de esta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
2026-07-02 feat(ci): Fase 4 — GitHub Actions (tests GameCore+Python, firmware ESP32, smoke Wokwi)
    Workflow CI en cada push/PR con dos jobs paralelos:
    - tests: scripts/run_all_tests.sh (C++ doctest + libgamecore.so + pytest);
    PyQt6/matplotlib headless (QT_QPA_PLATFORM=offscreen) + libs de sistema;
    pygame con SDL_VIDEODRIVER=dummy.
    - firmware-wokwi: pio run -e esp32dev (cache PlatformIO) + smoke test Wokwi
    (--expect-text del banner de boot). El paso Wokwi se omite con warning si
    falta el secret WOKWI_CLI_TOKEN (no rompe CI en forks/sin secreto).
    El smoke corre limpio en runners de GitHub (sin el black-hole IPv6 local a
    los endpoints de wokwi.com). El token va como Secret del repo, nunca en el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
2026-07-02 feat(cc): Fase 5 — subagentes + skills de hardware
    Subagentes (.claude/agents/, contexto aislado, tools mínimas):
    - circuit-reviewer (Read/Grep/Glob): coteja net list de cableado.md contra el
    mapa canónico Config.h; caza cortos 3V3↔5V, strapping (GPIO0/2/5/12/15), FSR
    fuera de ADC1, pines input-only/prohibidos. Reporta por severidad.
    - datasheet-reader (Read/Grep/Glob): extrae pinouts/specs de PDFs de
    docs/hardware/datasheets/ a tablas trazables; marca DESCONOCIDO si no está.
    - test-runner (Bash/Read): corre scripts/run_all_tests.sh y devuelve solo fallos.
    Skills (.claude/skills/, user-invocable):
    - design-review: checklist de revisión eléctrica (despacha circuit-reviewer).
    -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
2026-07-02 feat(cc): Fase 5 — MCP Wokwi/KiCad + subagentes/skills + TOOLING.md
    MCP servers (claude mcp add, verificados con claude mcp list):
    - Wokwi (.mcp.json scope project): wokwi-cli mcp, token por ${WOKWI_CLI_TOKEN}
    (referencia, nunca el valor). Activación: lanzar CC con ~/.secrets sourceado
    + aprobar el MCP de proyecto (Pending approval por seguridad).
    - KiCad (scope local, no commiteado): lamaalrajih/kicad-mcp en ~/code/tools/,
    KICAD_SEARCH_PATHS→docs/hardware/kicad/. Verificado ✔ Connected (log confirma
    search path + registro de tools).
    docs/hardware/TOOLING.md: fuente de verdad del entorno (versiones, comandos de
    uso por herramienta, rutas de config, registro MCP reproducible,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
2026-07-02 fix(cc): Fase 5 — Wokwi MCP a scope local con wrapper (token foolproof)
    Se verificó que el proceso de CC a menudo NO hereda WOKWI_CLI_TOKEN aunque se
    sourcee ~/.secrets antes de lanzar `claude` (evidencia directa esta sesión). El
    enfoque project .mcp.json con ${WOKWI_CLI_TOKEN} quedaba `Pending approval` +
    `Missing environment variables` → activación frágil.
    Fix: scripts/wokwi-mcp.sh sourcea ~/.secrets y ejecuta `wokwi-cli mcp`; registro
    en scope local (sin barrera de aprobación). Verificado `✔ Connected` SIN warning
    de env (antes/después es la prueba de que el token llega). Se elimina .mcp.json
    (ambos MCP quedan en scope local; TOOLING.md documenta el registro reproducible).
    C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
2026-07-02 docs(hw): Fase 6 — cableado.md guia de armado hueco-por-hueco definitiva
    Reescritura de docs/hardware/cableado.md como guia inequivoca para montar el circuito de una sola pasada: plano ASCII por zonas, columnas exactas (nodos FSR, ULN2803A, grupos LED, DFPlayer, caps), mapa boton-arnes, ruteo Fila J por Filas F-I + puente lateral, checklist con medicion en los rieles, secuencia de armado. Verificado: circuit-reviewer x2 (0 criticos) + lente armador primerizo + advisor + datasheet DOIT ESP32 DevKit V1 (header inferior NO espejado).
2026-07-02 docs(hw): Fase 6 — endurecer cableado.md para armado primerizo + datasheets
    Validacion exhaustiva de cableado.md: GO electrico (0 hallazgos criticos/altos/medios)
    por triangulacion (2x circuit-reviewer + KiCad .cir + datasheets + re-derivacion
    geometrica VIN/3V3 y ULN). Endurecido para un armador primerizo SIN tocar la topologia
    validada:
    - Orientacion del ESP32 + confirmar Fila A libre (previene el cruce col 25 que frie)
    - Checklist 8 partido en Bloque A (sin energia) / Bloque B (recien energizada) + '1a vez solo-ESP32'
    - P1/P4 (3V3/GND de la Fila J) anadidos a la 5; regla de nodos del protoboard
    - Armado del grupo LED + polaridad, FSR sin polaridad, jerga glosada, refs cruzadas
    Re-check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
2026-07-04 docs(hw): Fase 6 — reescribir cableado.md como guía de armado hueco-por-hueco
    Reescribe docs/hardware/cableado.md como guía paso-a-paso (§1–§5) para
    armador primerizo: mapa de zonas, 8 pasos en orden seguro con coordenadas
    FilaColumna exactas + color de cable + verificación, tablas de referencia
    y checklist con multímetro.
    Único cambio de topología: nuevo esquema de energía P1–P5 con waypoints en
    extremos (3V3 sube por col 1; 5V baja por col 64) — elimina el cruce de la
    col 25, los dos rieles + entran por extremos opuestos y nunca se tocan.
    FSR/ULN/LEDs/DFPlayer preservados verbatim (net list intacto vs Config.h).
    Verificado: circuit-reviewer (sin regresiones de pin/column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
2026-07-07 docs(plan): spec del rediseño 'pantalla del doctor' (A2)
    Rediseño del dashboard a una sola pantalla clínica: juego en vivo (izq) +
    métricas + análisis/recomendación (der), controles arriba, histórico en
    2ª pestaña. Conexión USB/Serial (FuenteSerial). Fundado en la verificación
    de GameCore (score por ronda, suggest W=4, set_level efectivo en RUNNING).
2026-07-07 feat(dashboard): pantalla del doctor — 3 paneles en vivo + USB/Serial
    métricas + análisis/recomendación (der), controles arriba (sin semilla),
    histórico en 2ª pestaña.
    - FuenteSerial (pyserial, no bloqueante, tolera no-JSON) + --serial; TDD loop://
    - Análisis en vivo: tendencia por ventana W=4 (derivada de deltas de score) +
    recomendación del motor (suggest) con botón Aplicar->set_level; color
    semántico verde=subir / ámbar=bajar / gris=mantener
    - Sesion acumula resultado por ronda; paneles.py (Juego/Metricas/Analisis)
    - Pulido QSS clínico (tablero oscuro, jerarquía, Noto Sans)
    - 56 pytest + C++ do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
2026-07-07 feat(fw): modo calibracion del umbral FSR + flashing por serial
    - main.cpp: bloque #ifdef CALIBRACION imprime las 6 lecturas crudas del ADC
    por serial cada ~200ms (sin juego ni WiFi) para calibrar UMBRAL_PISADA
    - platformio.ini: entorno esp32dev_calib (-DCALIBRACION); firmware normal intacto
    - flashing.md: conexion por --serial (era --tcp), calibracion real con el modo
    (el doc afirmaba que el ADC se veia en el serial; era falso)
    - Ambos entornos compilan SUCCESS (normal 60.2% flash; calib 30.7%, sin WiFi)
2026-07-07 feat(fw): modo calibracion registra min/max por FSR (captura el pico)
    El modo esp32dev_calib ahora muestra por cada FSR el valor actual y el
    [min..max] observados: el MAX captura el pico de la pisada aunque sea breve
    (evita tener que 'cazar' el valor instantaneo). Enter en el monitor reinicia
    min/max para medir otro sensor limpio. Compila SUCCESS (Flash 30.8%).
2026-07-07 feat(fw): modo calibracion v2 — deteccion de conexion + umbral automatico
    Rehace la salida del modo esp32dev_calib para calibrar sin ambiguedad:
    - Promedia 16 lecturas por canal (baja el ruido del ADC flotante de los pines
    sin sensor, que antes 'median' basura).
    - Marca cada FSR con ✓ (conectado Y detecta: registro una pisada real,
    salto reposo->pico >= 1000) o ✗ (sin sensor / sin pisada).
    - Calcula el umbral sugerido por sensor (reposo + 40%) y uno comun para los 6.
    - Bloque legible cada 800 ms; Enter reinicia. Compila SUCCESS.
2026-07-07 fix(fw): calibracion FSR muestra reposo/pico/rango siempre (no oculta el ADC)
    El modo v2 escondia las lecturas detras de un veredicto ✓/✗ con DELTA=1000,
    demasiado alto para prueba con el dedo -> los 6 canales salian ✗ aunque hubiera
    3 sensores conectados. Ahora imprime por canal act/reposo/pico/rango SIEMPRE;
    ✓ es solo una pista (rango>=150) y los numeros mandan. Un canal conectado se
    reconoce por su reposo estable; uno al aire da ~0 o ruido. Doc flashing.md §6 al dia.
    [main.cpp]
2026-07-07 docs: higiene de estado — sincroniza conteo de tests y ROADMAP con el estado real
    - CLAUDE.md: conteo pytest 36 -> 56 (verificado con run_all_tests.sh).
    - ROADMAP.md: deadline 4-jul -> 8-jul 18:00; HW montado marcado; calibracion
    UMBRAL_PISADA como paso EN CURSO; conexion de trabajo USB/Serial.
2026-07-08 docs(plan): spec de robustez integral del software (crash + defensiva + fuzzing + tolerancia)
    Diseño de 4 fases sobre dashboard/simulator (Python) + firmware/GameCore (C++):
    crash P0 (systematic-debugging), programación defensiva en boundaries, harness de
    fuzzing/monkey testing determinista, y tolerancia a fallos. Aprobado en brainstorming.
2026-07-08 docs(plan): plan de implementacion de robustez integral (4 fases, TDD)
    Crash P0 (systematic-debugging) -> defensiva en boundaries Py/C++ -> fuzzing
    determinista (GUI + protocolo Py/C++) -> tolerancia a fallos. Tareas bite-sized
    con TDD, cobertura de la spec verificada.
2026-07-08 fix(gamecore): set_mode en sesion activa la detiene (no deja modo sin iniciar)
    Causa raiz del crash del dashboard: SET_MODE durante RUNNING creaba el modo nuevo
    pero NO lo iniciaba ni cambiaba el estado. El modo quedaba en RUNNING con
    patron_/enPatron_ sin inicializar; el siguiente actualizar() disparaba
    fallar()->apagarPatron() sobre memoria basura y emitia 'led' con celda corrupta.
    En sesion.py ese IndexError, dentro de un slot Qt, se convertia en abort ('Python
    dejo de funcionar'). Mismo bug que ya se arreglo para SET_LEVEL. Afecta tambien al
    ESP32 (misma logica).
    Fix: SET_MODE en RUNNING/PAUSED apaga los LEDs y vuelve a IDLE (estado seguro,
    espera START). Regresion: test C++ determinist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
    [test_modo_equilibrio.cpp, test_robustez_gui.py]
2026-07-08 feat(dashboard): programacion defensiva en boundaries (sesion/fuente/paneles)
    - sesion._procesar valida cada campo del evento (celda en rango, tipos int,
    status str); una entrada malformada se descarta sin lanzar ni corromper estado.
    El ESP32 real por serial/TCP puede mezclar ruido con los eventos.
    - fuente: cota del buffer de recepcion (64 KiB) ante lineas sin '\n' (serial que
    escupe basura); helper _extraer_lineas comun a FuenteSerial/FuenteTCP.
    - paneles.PanelAnalisis tolera un 'suggest' incompleto (nivel/rate/window ausentes)
    sin KeyError.
    - test_defensivo.py cubre los tres boundaries.
2026-07-08 feat(gamecore): parser de protocolo robusto + cota de buffer de linea + fuzz
    - Protocol.cpp leerEntero ya NO usa std::stoll: un numero de >19 digitos hacia que
    stoll lanzara out_of_range -> abort del firmware (el ESP32 compila sin
    excepciones). Ahora parseo manual con saturacion (18 digitos, ignora el resto).
    - main.cpp: cota del buffer de linea (256 B) en serial y TCP: una linea sin '\n'
    ya no crece sin fin (protege la RAM del ESP32).
    - test_protocolo: caso de numeros gigantes. test_protocolo_fuzz: 40k lineas
    aleatorias + fragmentos + valores extremos; limpio bajo ASan+UBSan.
    Suite 66 pytest + C++ verde; pio run -e esp32dev SUCCESS.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
2026-07-08 feat(dashboard): guardas de estado ante comandos fuera de orden
    Doble start creaba una fila SQLite huerfana y reseteaba las metricas de la
    sesion en curso; ademas el preambulo de _start() (set_perfil/sembrar/
    configurar) reenviaba set_seed/set_mode a mitad de partida, dejando el motor
    detenido sin reiniciarlo. Guarda: _start() ignora el clic si ses.estado ya es
    running/paused. Los otros 5 escenarios del brief (stop sin start, pause sin
    sesion, cambiar modo/nivel a mitad de juego, aplicar sin datos, exportar sin
    sesion) ya eran coherentes por fixes previos; se agregan tests que lo prueban.
    [app.py, test_defensivo.py]
2026-07-08 fix(dashboard): guarda de doble start robusta ante clics sin tick intermedio
    La guarda de _start() (commit 432123a) leia ses.estado, que solo se
    actualiza al bombear eventos (tick de 25 Hz); un doble clic real, sin que el
    timer corriera entre medias, seguia creando una fila SQLite huerfana porque
    el evento "state":"running" del primer start aun no se habia drenado. Fix:
    bombear() antes de leer estado (el evento ya esta encolado en el core de
    forma sincrona, solo falta drenarlo). Agrega el test que expone el caso.
    [app.py, test_defensivo.py]
2026-07-08 test(dashboard): cubre nivel (no solo modo) a mitad de juego en 2.3
    sp_nivel.valueChanged dispara el mismo _configurar() -> set_mode que
    cb_modo (no el set_level de "Aplicar"); el brief lista "modo/nivel" por
    separado, asi que se agrega el caso explicito aunque comparte handler y
    guarda con el ya cubierto para cb_modo.
2026-07-08 feat(dashboard): storage/export degradan sin tumbar la GUI
    Almacen y reportes ahora lanzan excepciones propias (AlmacenError,
    ReporteError) en vez de dejar subir sqlite3.Error/OSError/ValueError sin
    control. Se capturan en la frontera GUI: _exportar() refleja el fallo en
    lbl_export en vez de propagar, y _abrir_almacen() evita que una DB corrupta
    o una ruta invalida aborte el arranque de la ventana (degrada a memoria
    con aviso visible por stderr).
    [app.py, reports.py, storage.py, test_defensivo.py]
2026-07-08 fix(dashboard): _exportar tolera fallo de makedirs (no crashea la GUI)
    os.makedirs(DIR/reportes, exist_ok=True) vivia fuera del try/except de
    _exportar: si "reportes" ya existe como archivo plano (no directorio),
    exist_ok=True no evita el FileExistsError, y esa excepcion cruda llegaba
    sin control al slot de Qt. Se mueve la llamada dentro del try y se amplia
    el except a (OSError, ReporteError).
    [app.py, test_defensivo.py]
2026-07-08 feat(gamecore): rangos seguros en set_level/set_mode/pisar
    set_level/set_mode no validaban el rango de sus argumentos: un nivel fuera de
    [1,4] corrompia nivel_ de forma permanente, y un modo desconocido dejaba
    modoId_ en un valor inexistente (ademas de detener una sesion RUNNING solo
    por recibir basura). pisar() tampoco acotaba celda a [1,CELDAS], filtrando un
    evento 'press' con celda inexistente hacia el protocolo. Guardas en la
    frontera de la API del motor: comandos invalidos se ignoran completos, sin
    efectos secundarios. 4 tests nuevos (TDD: RED con 9 asserts fallando, luego
    GREEN); suite completa 52 casos/2174 asserts + 84 pytest, verde.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
2026-07-08 test(dashboard): fuzz determinista del parser de protocolo
2026-07-08 test(dashboard): monkey de GUI multi-seed en la suite
    Generaliza el monkey de robustez de la GUI (Fase 1) a un test permanente:
    3 seeds fijas (0,1,2) x 5000 eventos cada una, reproducible al 100%.
    Confirma que el endurecimiento de boundaries (Task 2.3/2.4) sostiene la
    GUI sin crashes ni excepciones no capturadas bajo fuzzing.
    [test_robustez_gui.py]
2026-07-08 feat(dashboard): red de seguridad global — la GUI nunca muere
    Dos utilidades en robustez.py: ejecutar_seguro(fn, logger) envuelve tick() y
    los handlers de app.py en su propio cuerpo (cubre tanto la llamada directa
    como la disparada por Qt); instalar_excepthook(logger) es la red de respaldo
    para lo que quede sin envolver, instalada al arrancar en main().
    Verificado empíricamente (PyQt6 6.11.0): una excepción que escapa de un slot
    Qt sin sys.excepthook propio aborta el proceso (SIGABRT); con un hook propio
    que solo registra, el proceso sigue vivo. Ninguna excepción se silencia sin
    rastro: ejecutar_seguro/instalar_excepthook siempre loguean antes de tragar.
    El monkey de 3.1 sigue verde y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
2026-07-08 feat(dashboard): degradacion visible ante caida de fuente/DB
    Añade un indicador de estado ("Conectado"/"Degradado: ...") en la ventana
    del dashboard: se actualiza desde tick() cuando Fuente.recibir() o el
    Almacen fallan (via un hook on_error en ejecutar_seguro), y cuando el
    transporte de FuenteTCP reporta caido. Tambien refleja en la UI el caso ya
    manejado en 2.4 donde el Almacen real degrada a memoria al arrancar (antes
    solo avisaba por stderr).
2026-07-08 fix(dashboard): degradacion de almacen sticky + guarda on_error en la red de seguridad
    [app.py, robustez.py, test_defensivo.py]
2026-07-08 feat(fw): lazo acotado y tolerante a cliente/entrada
    Cierra Task 4.3: cota de bytes por vuelta en la lectura de linea (TCP y
    Serial), reset del buffer de linea del cliente al aceptar una sesion nueva
    (evita mezclar bytes de un cliente caido con el siguiente), y guarda de
    escritura no bloqueante en emitir() para no repetir un bloqueo de ~20s en
    cada evento si el cliente TCP deja de leer sin desconectarse. Confirmado
    por lectura del framework: accept/available/read ya eran no bloqueantes y
    la reasignacion de WiFiClient ya liberaba el socket viejo.
    [main.cpp]
2026-07-08 docs: CLAUDE.md — conteos reales (52c/2174a/100 pytest) + trampas de robustez integral
2026-07-08 fix(test): el monkey de GUI detecta excepciones absorbidas por la red de seguridad
    ejecutar_seguro (robustez.py) atrapa y loguea cualquier excepcion interna sin
    propagarla; como todas las acciones del monkey pasan por ella, este se habia
    vuelto ciego a fallos internos y solo detectaba un abort/segfault real. Se
    adjunta un logging.Handler al logger 'app' (el mismo que usa ejecutar_seguro) a
    nivel ERROR, alimentando 'fallos' junto al excepthook existente.
    [test_robustez_gui.py]
2026-07-08 feat(dashboard): pulido visual integral de la pantalla del terapeuta
    - Paleta clinica unica en estilo.py, compartida por el QSS y las graficas del
    Historico (via GRAFICO): matplotlib abandona los colores tab:* (chocaban con
    el sistema teal) y usa verde/rojo/teal/ambar/azul-pizarra -> las dos pestanas
    por fin leen como un solo producto, no como dos aplicaciones.
    - Estado del juego como chip semantico (idle/running/paused/finished) y estado
    de conexion movido de setStyleSheet inline a chip QSS [estado=ok/degradado];
    ambos re-polish solo al cambiar (mismo patron que PanelAnalisis._pintar_dir).
    El texto conserva la palabra de estado en minuscula (lo leen los tests).
    - Foco de teclado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
2026-07-08 feat(hardware): plantilla imprimible del gráfico de la tapa (acetato, escala real)
    Plantilla a tamaño real para imprimir en acetato A3 y montar sobre la tapa.
    Generador en mm (scripts/gen_grafico_tapete.py) -> SVG editable + PDF de página
    A3 exacta (MediaBox 1190.55x841.89 pt verificado). El arte mide 390x260 mm
    (39x26 cm); el cuadro interior 328x195 mm (32.8x19.5) va centrado con los 6
    botones (Ø56 mm) en 8.2/16.4/24.6 x 6.5/13.0 cm segun el prototipo real. Botones
    con relleno translucido + numero central; confeti de borde; guias de zona de
    juego; marcas de corte + regla de calibracion de 100 mm + leyenda 'imprimir al
    100%'. README con instrucciones (incl. prueba en papel sobre la tapa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
2026-07-08 docs(spec): diseño de reproducibilidad y empaquetado para Windows 11
    Dos niveles (paquete molido para el médico vía ZIP de release + entorno dev
    reproducible para el mantenedor). Cliente descarga el release construido por CI
    (runner Windows); médico abre un lanzador sin Python ni compilador. Chip USB
    confirmado = CP210x (10c4:ea60) para driver y auto-detección de COM.
2026-07-08 docs(plan): plan de implementación de reproducibilidad/empaquetado Windows
    6 tareas TDD: fijar deps, core_bridge multiplataforma+frozen-safe, auto-detección
    COM (CP210x), spec PyInstaller + .bat de respaldo, docs (guía médico + dev-windows),
    y CI Windows (build/tests/exe/smoke-sin-deps/release). Gate de evidencia = el .exe
    arranca en un job sin pip install.
2026-07-08 build: fijar versiones exactas de dependencias (reproducibilidad)
    Cambia las tres requirements files de pisos (>=) a pins exactos (==):
    - PyQt6 6.6 → 6.11.0, matplotlib 3.8 → 3.11.0, pyserial 3.5 (igual)
    - pygame 2.5 → 2.6.1
    - pytest 8.0 → 9.1.1, platformio 6.1 → 6.1.19
    Verificado: pip install + suite completa TODO VERDE (52 C++/2174a + 101 pytest).
2026-07-08 build(packaging): spec PyInstaller (onedir) + instalador .bat de respaldo
2026-07-08 docs(plan): añadir Task 5b — el ejecutable congelado arranca con --serial auto
    Hueco detectado en el review de Task 5: la guía del médico promete auto-conexión
    al doble clic, pero el .exe sin argumentos caería en modo práctica. El spec §5.5
    exige --serial auto en el .exe. Task 5b lo cumple (default frozen).
2026-07-08 feat(dashboard): el ejecutable congelado arranca con auto-deteccion (--serial auto)
    El review de Task 5 detecto que la guia del medico promete conexion automatica
    al doble clic, pero el .exe sin argumentos caia en modo practica. Se agrega
    puertos.serial_por_defecto(): en el congelado sin --serial/--tcp resuelve a
    "auto"; en dev sigue None; un valor explicito siempre manda.
2026-07-08 ci: job Windows — tests, empaquetado del .exe y smoke sin deps
    Añade windows-build (corre la suite vía bash, construye libgamecore.dll
    y el .exe con PyInstaller, empaqueta ZIP con driver CP210x + guía del
    médico), windows-smoke (gate de evidencia: --smoke sin pip install) y
    windows-release (adjunta el ZIP al Release en tags). No modifica los
    jobs Linux existentes (tests, firmware-wokwi).
2026-07-08 fix(ci): trigger en tags, timeout Windows y stdio guard para --smoke
    - Fix A: on.push agrega tags:['**'] — sin esto, git push de un tag nunca
    disparaba el workflow y windows-release (gateado a refs/tags/) jamas corria.
    - Fix B: timeout-minutes: 30 en windows-build para que un choco/pip/PyInstaller
    colgado falle rapido en vez de agotar las 6h por defecto en el runner Windows.
    - Fix C: en app.py, si sys.stdout/stderr son None (build "windowed" de
    PyInstaller, console=False) se redirigen a devnull antes de --smoke o main();
    cualquier print() sin esto abortaria el gate de evidencia del .exe en CI.
    [app.py]
2026-07-08 fix(windows): degradacion segura al arrancar, smoke cubre list_ports, reencuadre de instalar.bat
    Fixes finales de la revision de rama del empaquetado Windows:
    - construir_fuente_segura() en fuente.py: si la fuente elegida falla al
    abrir (puerto ocupado, backend faltante en el exe congelado), degrada a
    modo practica con aviso visible en vez de matar la GUI en silencio
    (stderr va a devnull en el .exe windowed).
    - smoke() ahora ejercita serial.tools.list_ports (puertos_tapete()), el
    import real que dispara cualquier doble clic, no solo FuenteCore.
    - instalar.bat y el spec de diseno se reencuadran como conveniencia de
    DEV (requiere el arbol de fuente), no como respaldo del cliente.
    - C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
    [app.py, fuente.py, test_fuente_serial.py]
2026-07-09 docs(spec): alinear §2 con §5.6/§11 — el .bat es conveniencia dev, no respaldo del cliente
    El fix del review final reencuadró §5.6/§11 pero dejó §2 diciendo "respaldo
    commiteado", contradictorio. §2 ahora coincide: el .exe es la única entrega al
    cliente; el .bat corre desde el checkout (dev).
2026-07-09 fix(windows): binarios C++ estaticos + tests de export sin chmod POSIX
    Suite verde en el runner de Windows (Git Bash):
    - run_all_tests.sh: en MINGW/MSYS enlaza los binarios de test estaticos
    (-static*), si no cargan un libstdc++ incompatible del PATH de Git-for-Windows
    y crashean al arrancar (0 salida doctest). Linux intacto. +rc en el fallo.
    - test_defensivo: los 2 tests de "ruta sin permiso" usaban chmod(0o000), que NO
    bloquea escritura en Windows -> ahora el padre es un ARCHIVO (OSError en ambos
    SO -> ReporteError). Mantiene cobertura, cross-platform.
    [test_defensivo.py]
2026-07-09 fix(packaging): rutas absolutas en el spec (SPECPATH) — PyInstaller no hallaba el entry
    En un .spec las rutas relativas de Analysis se resuelven contra el dir del spec
    (packaging/), no el cwd: buscaba packaging/dashboard/app.py. Anclando a la raiz
    via SPECPATH, el entry y pathex son absolutos y correctos desde cualquier cwd.
2026-07-09 tools(hw): verificador de pisadas por celda desde la BD de sesiones
    La GUI no pinta el evento 'press' (solo los LEDs) y el motor unicamente lo
    emite en RUNNING: sin este script no hay forma de saber que FSR respondio.
    Lee los eventos de la sesion y distingue sensor mudo de sensor stuck-high
    (reposo por encima del umbral: dispara una vez al arrancar y luego calla).
    [verificar_pisadas.py]
2026-07-09 docs(articulo): incorporar Articulo_Mejorado.docx como fuente de verdad
    Reemplaza a Articulo_Tapete_Interactivo como base de la reescritura. Entra al
    repo privado de desarrollo para tener historial; la depuracion de rastros se
    hace al preparar la entrega, no aqui.
2026-07-09 docs: conciliar el estado del proyecto — ROADMAP como fuente unica
    El ROADMAP seguia anunciando un deadline vencido (8-jul), la calibracion del FSR
    como "en curso" y el CI como pendiente de crear. CLAUDE.md afirmaba "todo verde"
    con 100 pytest (son 119) y omitia packaging/ y .github/.
    - ROADMAP.md: reescrito como fuente unica del estado (software, CI, hardware,
    articulo) y del trabajo pendiente. Prioridad exclusiva: el articulo.
    - CI documentado como ROTO, no como hecho: `windows-smoke` no declara
    `timeout-minutes` y GitHub lo mata al llegar a las 6 h; `windows-release`
    depende de el, asi que el ZIP entregable nunca se ha producido. Evidencia de
    los runs 28985648809 y 29037127207.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
2026-07-09 feat(evidencia): jugadores simulados de Memoria y Equilibrio + pipeline del articulo
    El articulo solo podia reportar evidencia por simulacion del modo Velocidad: el
    jugador simulado unicamente sabia reaccionar a la unica casilla encendida. Memoria
    exige memorizar la secuencia exhibida y repetirla; Equilibrio, pisar k casillas
    simultaneas. Sin estos jugadores, dos de los tres modos quedaban sin validar.
    - `jugador_modos.py`: politicas deterministas para Memoria y Equilibrio contra el
    MISMO libgamecore.so. El fin de la exhibicion de Memoria se detecta por silencio
    CON todas las casillas apagadas (mientras un LED esta encendido, hasta 600 ms, el
    motor tampoco emite eventos: esa era la tr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
2026-07-09 feat(evidencia): verificacion estadistica del motor + coste computacional
    Las figuras del articulo ilustraban la adaptacion; ahora la VERIFICAN. Una ronda
    solo se gana encadenando aciertos: 1 pisada en Velocidad, k en Equilibrio, L en
    Memoria. Con un jugador que acierta cada pisada con probabilidad h, la teoria
    predice P = h, h^k y h^L. Medido sobre 200 semillas: **11/11 puntos caen dentro
    del IC 95 %**. El motor implementa la regla que dice implementar.
    - `montecarlo.py`: tasas por modo con IC 95 %, contrastadas con la prediccion.
    - `scripts/bench_nucleo.cpp`: coste del nucleo en C++ puro. La primera version
    medía 1,6 ns/pisada porque tras 5 rondas la sesion terminaba y las pisadas se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
2026-07-09 docs(articulo): articulo unificado en Markdown, con evidencia medida y refs verificadas
    Fuente unica: `docs/articulo/articulo.md` (11 900 palabras) -> .docx y .pdf via
    pandoc + citeproc (APA 7). El build falla si queda una cita sin resolver.
    Contenido:
    - Estructura completa: introduccion, marco teorico, estado del arte (con la brecha
    identificada), metodologia, resultados E1-E8, discusion, limitaciones,
    consideraciones eticas, trabajo futuro (PCB + reproducibilidad en clinica) y
    conclusiones.
    - Ninguna cifra escrita a mano: todas salen de `scripts/experimentos.py`.
    - Resultado central: la probabilidad de ganar una ronda es h, h^k y h^L segun el
    modo; 11/11 puntos medidos sobre 200 s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
2026-07-09 docs(articulo): unificar — un solo documento fuente
    Los dos borradores quedan absorbidos en `articulo.md`: el marco teorico y el
    estado del arte vienen del Mejorado; metodologia, resultados y analisis, de la
    version previa, reencuadrados y ampliados con la evidencia medida. Ambos siguen
    en el historial (ab69ba6) si hiciera falta consultarlos.
    El anteproyecto V3 NO se toca: es el documento guia del profesor.
2026-07-09 docs(roadmap): el articulo pasa a construido y verificado; queda el tidy de la figura KiCad
2026-07-09 fix(articulo): correcciones de la auditoria de integridad
    Auditoria independiente contra las fuentes del repo. Tres discrepancias, todas
    confirmadas por mi contra el JSON y golden_vectors.json antes de corregir:
    - E2 decia "tres de los ocho escenarios en modo estricto"; son **dos** (los otros
    seis son subsecuencia). El error nacio de que ese conteo NO salia del guion de
    experimentos: ahora `experimentos.py` lo deriva de `golden_vectors.json` y lo
    escribe en `resultados.json`, para que no pueda volver a divergir.
    - Tabla 5: dos redondeos erroneos de ±0,001 (Memoria L=3 medido 0,593 no 0,594;
    Velocidad h=0,5 IC ±0,024 no ±0,025).
    - E8 decia "de tres a cinco ordenes de magnitud"; so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
    [experimentos.py]
2026-07-09 fix(articulo): correcciones de la revision de estilo academico
    Revision independiente de redaccion. Aplicado:
    - **Aclarada la trampa de la Figura 2**: el eje Y es la tasa de la SESION, pero la
    direccion se decide sobre la ventana de las 4 ultimas rondas. A h=0,4 la sesion
    cierra con 62,5 % y aun asi recomienda subir. Verificado: las 4 rondas finales
    dan exactamente 75 %. Sin la aclaracion, un revisor leeria una contradiccion con
    la regla del 75 %.
    - Lexico de Colombia: `coste`->`costo` (10), `railes`->`rieles`, `altavoz`->`parlante`.
    - Taxonomia de E8 coherente en las tres menciones: E1-E7 por simulacion, E8 en banco
    de software (antes se englobaba como "por software" y la tabla d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
    [experimentos.py]
2026-07-09 fix(articulo): pie de figura falso, figura del prototipo y reproducibilidad real
    Revision visual del PDF renderizado (no solo "el build pasa"):
    - **El pie de la Figura 1 mentia**: decia "inventario (izquierda) y caja ensamblada
    (derecha)" cuando la imagen es solo el inventario. Corregido, y añadida la Figura 2
    con el prototipo ensamblado — que el articulo afirma que existe. Renumeradas las
    figuras 3/4/5 y todas sus menciones en prosa.
    - **La afirmacion de reproducibilidad era falsa.** El articulo dice que un unico guion
    genera todas sus figuras, pero la de adaptacion la producia `generar_evidencia.py`.
    Ahora `experimentos.py` lo invoca: un solo comando reproduce las cinco figur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
    [experimentos.py]
2026-07-09 feat(figuras): planos KiCad, diagrama de bloques y simulacion SPICE en el articulo
    El articulo solo tenia figuras de simulacion de la logica y dos fotos. Ahora
    incorpora la ingenieria electrica, con la misma regla: ninguna figura se dibuja a
    mano y ninguna puede divergir del codigo.
    **KiCad.** El esquematico era un auto-layout ilegible: la sexta columna de LEDs se
    salia del marco, el cajetin estaba vacio y cada etiqueta de net se dibujaba encima
    de su componente. Arreglado:
    - `kisch.py`: soporte de cajetin (`TitleBlock`) y etiquetas justificadas HACIA AFUERA
    del simbolo (los pines del lado izquierdo llevaban el texto sobre el cuerpo).
    - `gen_tapete.py`: layout por bloques funcionales (sen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
    [tapete.kicad_sch]
2026-07-09 fix(evidencia): el benchmark no es determinista — reportarlo como mediana y rango
    Al reejecutar la cadena completa, `resultados.json` cambiaba: el bench del nucleo
    oscilaba entre 4,8 y 6,4 ns por tick. El articulo citaba esas cifras como exactas y
    ademas afirmaba que "su ejecucion reproduce exactamente los valores aqui reportados".
    Falso para E8: es una medida de tiempo de ejecucion, no una simulacion determinista.
    - `experimentos.py`: el bench se corre 7 veces; se reportan mediana, minimo y maximo.
    - Articulo E8: tick 5,7 ns (4,4-5,9); pisada 463 ns (451-538); sesion 5,6 us (5,4-6,5).
    - "Disponibilidad de la evidencia": se declara la excepcion explicitamente, en vez de
    sostener una rep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
    [experimentos.py]
2026-07-09 docs(articulo): quitar magnitudes de HW sin fuente y cifras no deterministas
    Dos infracciones de la disciplina del proyecto, en el mismo parrafo de E9/E8:
    - E9 afirmaba que la pisada baja la R del FSR "casi tres ordenes de magnitud
    por debajo de su valor en reposo, que es de megaohmios". Ninguno de los dos
    numeros tiene fuente: salen del extremo del barrido asumido en
    divisor_fsr.cir, no de un datasheet (no hay datasheet del FSR en el repo) ni
    de una medicion. La R de reposo esta sin caracterizar: es justamente E11.
    El resultado exacto de E9 -- umbral 2000 cuentas <-> R_FSR = 10,5 kOhm -- no
    se ve afectado; solo se retira la magnitud contextual inventada.
    - E8 citaba valores ex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
2026-07-09 docs(kicad): acotar la afirmacion de reproducibilidad al .kicad_sch
    Verificado al regenerar: el .kicad_sch sale byte a byte identico, pero el .pdf
    no. Unico byte que cambia: /CreationDate, que kicad-cli estampa con la hora de
    exportacion (D:2026:07:09:14:57:40 -> :15:14:00); el texto extraido es identico.
    Sin esta nota, quien regenere ve tapete.pdf modificado y concluye que la
    reproducibilidad esta rota.
2026-07-09 docs(articulo): retirar un absoluto falsable sobre el bench
    "siempre por debajo de 10 ns" es una cota dura sobre una medida ruidosa: el
    maximo observado fue 6,4 ns en una maquina descargada, pero un tick aislado
    puede excederla bajo carga. El argumento (seis ordenes de magnitud por debajo
    de la ventana de 1000 ms) no necesita la cota.
    Verificado ademas que E8 no aparece en ninguna tabla: las unicas cifras del
    bench en el articulo son las dos frases de orden de magnitud.
2026-07-09 docs(roadmap): fijar el sondeo profundo del articulo como proxima accion
    Deja escritos los cuatro invariantes que ya costaron una correccion, para que
    la auditoria del chat fresco no los redescubra.
2026-07-10 docs(articulo): auditoria a fondo — listo para revision
    Sondeo profundo del articulo antes de enviarlo a revision: veracidad,
    cifras, bibliografia, redaccion y rastros de IA.
    Integridad:
    - Acotada la afirmacion de que "todas" las cifras salen de un guion:
    falso para robustez (codigo de los tests), huella (compilador) y
    cobertura (runner). Corregido en Resultados y Disponibilidad.
    - E8 desincronizado: se eliminan las medianas puntuales (el bench no es
    determinista); "mas de seis ordenes" -> cinco (robusto en todo el rango).
    - Cobertura: 135 -> 137 pytest (medido).
    Bibliografia (29/29 verificadas en linea; ninguna fabricada):
    - grieco: Seligsohn Karen (no Kate), Schwartz Alison (no A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
2026-07-10 docs(evidencia): paquete de evidencia de software para el redactor externo
    Material de metodología y ejecución para quien redacta el documento académico:
    - articulo/stack-tecnologico.md: lenguajes, librerías y herramientas con versiones,
    separando el stack del prototipo del de composición del artículo.
    - evidencia/GUIA_EVIDENCIA.md: índice que responde punto por punto lo pedido
    (procedencia de gráficas, protocolo, estado del hardware, fotos del autor), con
    la línea de integridad: todo es software, sin evidencia de hardware "funcionando".
    - evidencia/ejecucion/: logs (suite verde, firmware SUCCESS, experimentos), traza
    real del protocolo de los 3 modos, golden vectors 8/8, ca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
2026-07-10 docs(roadmap): diagnóstico de hardware resuelto; foco = hardware
    Los 6 sensores FSR están sanos: sin el acrílico responden de inmediato (pico
    ≈4068-4095, reposo 0 en los seis). La falla era mecánica —el acrílico rígido no
    transmite la fuerza al FSR—, no eléctrica; el riel 3V3 estaba bien.
    - §3: reescrito con el diagnóstico y la prueba end-to-end sin acrílico en curso
    (Velocidad n1, Equilibrio n3, Memoria n1); pendientes el acrílico definitivo
    (concentrador + recalibrar, o prescindir) y el umbral final.
    - §1: el artículo queda delegado a un redactor externo (evidencia ya entregada).
    - Punto de continuación al 2026-07-10.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
2026-07-10 docs(modos-audio): spec y plan de correcciones de modos + sistema de audio
2026-07-10 fix(dashboard): semilla aleatoria por partida (secuencias distintas)
    El dashboard enviaba set_seed con una semilla fija (SEMILLA_DEFECTO=12345) en
    cada Start, por lo que la secuencia de los modos era siempre la misma. Ahora la
    semilla es aleatoria por partida salvo que se fije (smoke/tests reproducibles).
    [app.py, test_semilla.py]
2026-07-10 feat(sim): tecla R re-siembra el RNG (cierra desfase doc/codigo)
    La tecla R estaba documentada en el docstring del simulador pero no
    implementada. Ahora envia set_seed con semilla aleatoria al core.
2026-07-10 feat(core): constantes de sonido (inicio/acierto/ronda/fin) + pausa de memoria
    Alias transitorios INSTRUCCION/ERROR/EXITO conservados hasta migrar los modos.
2026-07-10 feat(velocidad): ACIERTO por pisada correcta, error mudo
    [test_modo_velocidad.cpp]
2026-07-10 feat(equilibrio): ACIERTO por casilla, RONDA al completar, error mudo
    [test_modo_equilibrio.cpp]
2026-07-10 feat(memoria): fase PAUSA (~1.2s) + audio por LED/acierto/ronda, error mudo
    Pausa clara (todo apagado) antes de la 1a exhibicion, entre rondas y tras error:
    elimina la transicion instantanea que impedia ver el primer boton. La exhibicion
    y cada acierto intermedio suenan ACIERTO; completar la serie suena RONDA; el error
    es mudo. No bloqueante (via actualizar()).
    [test_modo_memoria.cpp]
2026-07-10 refactor(core): eliminar alias de sonido viejos (mapa final inicio/acierto/ronda/fin)
2026-07-10 fix(sim): jugador de memoria detecta la exhibicion por fase, no por sonido
    El nuevo audio hace que exhibicion y confirmacion suenen igual (ACIERTO); la
    heuristica vieja (sound id==1) ya no distingue. Ahora la secuencia se arma con
    los LED>0 recibidos antes de la fase de entrada. Mismos hits/misses: la logica
    de aciertos no cambia (montecarlo/evidencia intactos).
2026-07-10 fix(memoria): la exhibicion arranca en el instante logico de fin de pausa
    Usar tTrans_ (no ms) como base evita que la exhibicion se estire si un update
    tarda o el reloj salta; el while se pone al dia procesando las transiciones
    vencidas. Necesario para reproducir la sesion completa con saltos de reloj grandes.
2026-07-10 test(golden): regenerar vectores con el nuevo mapa de sonidos
2026-07-10 feat(audio): generador determinista + 4 tonos (inicio/acierto/ronda/fin)
    numpy -> ffmpeg -> MP3 mono 44.1k/128k (compatible DFPlayer). Sirven al simulador
    (audio/) y a la microSD del ESP32 (/mp3/).
2026-07-10 docs(hardware): checklist de diagnostico del ghosting de LEDs en Equilibrio
2026-07-10 fix(equilibrio): pisadas parciales mudas; solo suena al completar el patron
    Ajuste a lo pedido: en Equilibrio el sonido marca 'se pulsaron TODOS los botones
    del patron' (un solo tono de ronda), no cada pisada parcial.
    [test_modo_equilibrio.cpp]
2026-07-10 docs(roadmap): E2E hecha, modos corregidos + audio; sincronizar estado y cuentas
    Actualiza ROADMAP §3 y la linea base (58c/2186a C++ + 140 pytest), CLAUDE.md y el
    spec (Equilibrio suena solo al completar). Proxima accion = reflashear, copiar audios
    a la SD, validar los 3 modos + diagnostico del ghosting de LEDs.
2026-07-11 diag(audio): entorno esp32dev_audio para aislar el fallo del DFPlayer
    Prueba el modulo capa por capa (UART -> microSD -> reproduccion) e imprime donde
    falla, con reintentos de begin() y espera de 3 s (el firmware del juego solo
    esperaba 50 ms, y el timeout de la libreria es 500 ms).
2026-07-11 diag(audio): detectar reinicios del modulo y bajar a volumen moderado
    El log mostro 'microSD ONLINE' repetido = el DFPlayer se reinicia al reproducir
    (sobrecorriente del amplificador). El diagnostico ahora cuenta los reinicios y
    usa volumen 15: cableado.md §7 exige volumen moderado con el parlante de 4 Ohm
    sobre USB (el v1 usaba 30, el maximo, agravando el pico).
2026-07-11 fix(audio): esperar y reintentar el arranque del DFPlayer + volumen moderado
    Causa raiz del silencio, hallada en banco:
    1) HARDWARE: faltaban los caps de desacople -> el amplificador (4 Ohm) hundia el
    riel de 5 V del USB y el modulo se reiniciaba en bucle al reproducir. Resuelto
    montando 100 uF + 100 nF (VCC-GND del modulo) y 1000 uF (rieles de 5 V):
    0 reinicios y el parlante suena. Documentado el sintoma en cableado.md §7.
    2) FIRMWARE: begin() se llamaba a los 50 ms con timeout de 500 ms, pero el DFPlayer
    tarda 1-3 s en montar la SD -> audioOk_=false y el tapete quedaba MUDO toda la
    sesion. Ahora espera 1,5 s, sube el timeout a 1 s y reintenta 3 veces.
    3) Volumen 22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
    [EspHardware.cpp]
2026-07-11 feat(audio): volumen al maximo del modulo (30)
    El DFPlayer admite 0..30 (no 50). A peticion del autor se sube de 15 al maximo;
    se sostiene gracias al desacople ya montado. Si hay reinicios o distorsion, ~22.
2026-07-11 fix(audio): volver a volumen 15 — a 30 el modulo entra en brownout y no suena
    Limite verificado en banco: el parlante de 4 Ohm sobre USB no sostiene el maximo ni
    con el desacople montado. 15 = estable y con sonido. Para subir, ir de a poco (18/20/22)
    verificando reinicios con el entorno esp32dev_audio.
2026-07-11 docs(roadmap): audio funcionando en hardware; proxima accion = normalizar tonos
    Cierre de sesion: registra las 2 causas del silencio (falta de desacople + begin()
    a los 50 ms), el techo de volumen verificado (15; a 30 hay brownout) y el entorno
    esp32dev_audio como herramienta de diagnostico.
2026-07-11 feat(audio): normalizar los tonos — mas fuertes y nitidos sin subir el volumen
    El volumen del modulo topa en VOLUMEN_AUDIO=15 (a 30 hay brownout y deja de
    sonar), asi que la ganancia se busca en el archivo: melodias transpuestas dos
    octavas (2-4 kHz, la unica palanca gratis en corriente: pico de sensibilidad del
    oido y mejor rendimiento del altavoz pequeno), armonicos 2f/3f, compresion tanh
    (sube el RMS sin subir el pico) y 30 ms de silencio inicial (el DFPlayer se come
    el ataque). Medido sobre el MP3 decodificado: +3,2 a +4,0 dB de RMS.
    Dos limites duros, ahora fijados en simulator/test_audio.py:
    - El tono de acierto NO se alarga a 0,5 s como pedia el plan: suena en cada
    pisada y en c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
    [gen_audio.py]
2026-07-11 docs(roadmap): cifrar la ganancia con base homogenea y anotar la duda de los agudos
    - La tabla comparaba la onda cruda vieja contra el MP3 nuevo: bases distintas. Medido
    MP3 decodificado contra MP3 decodificado, la ganancia real es +3,6 a +4,5 dB de RMS.
    - La ganancia percibida por el cambio de frecuencia NO se cifra: no esta medida (haria
    falta caracterizar el altavoz).
    - Queda anotada una cuestion abierta para la prueba con usuarios: la banda de 2-4 kHz se
    eligio por el oido tipico, pero la hipoacusia neurosensorial (frecuente en sindrome de
    Down) degrada justo los agudos. Se confirma escuchando; la decision es del terapeuta.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
2026-07-11 fix(hardware): LEDs a 110 ohm — sincronizar TODAS las fuentes con el tapete real
    El autor cambio las 6 resistencias de grupo de 2.2 kOhm a 110 Ohm porque el brillo
    era demasiado tenue, y verifico en hardware los 3 modos x 3 niveles con los tonos
    nuevos: todo funciona, sin brownout (incluido Equilibrio n3, el peor caso: 4 grupos
    encendidos + audio).
    Medido con ngspice (instrumento del proyecto), no a mano:
    - antes: 0,58 mA por grupo / 0,19 mA por LED -> tenue
    - ahora: 10,1 mA por grupo / 3,4 mA por LED -> ~61 mA los 6 grupos
    Sigue un orden de magnitud por debajo del ULN2803A (500 mA/canal de maximo absoluto,
    uln2803a.pdf). El maximo del LED es DESCONOCIDO: no hay datasheet del LED en e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
    [tapete-bom.csv, tapete.kicad_sch]
2026-07-11 fix(evidencia): resincronizar el articulo con resultados.json regenerado
    Al regenerar resultados.json (por el cambio de R de los LEDs) salio a la luz que el
    json commiteado llevaba DESACTUALIZADO desde la tanda de modos/audio: el jugador
    simulado cambio de comportamiento (semilla por partida, pausas de Memoria) y nadie
    volvio a correr experimentos.py. Verificado valor por valor contra el articulo:
    - La afirmacion central SIGUE SIENDO CIERTA: 11/11 puntos del Monte Carlo dentro del
    IC 95 %, antes y despues. La tabla de Velocidad y Equilibrio no se movio.
    - Desincronizada UNA fila (Memoria, L=6): el articulo citaba 520 rondas / 0,385, el
    json da 519 / 0,383. Corregida a la cifra medida.
    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
2026-07-11 diag(ci): instrumentar el smoke del .exe y ponerle timeout
    windows-smoke se colgaba hasta el limite de 6 h del runner y no dejaba diagnostico:
    el .exe se compila con console=False, asi que sys.stdout es None y cualquier traza
    se pierde. La hipotesis que teniamos documentada (un QMessageBox modal en main) es
    FALSA: --smoke se intercepta antes de main() y smoke() no entra en el bucle de
    eventos de Qt.
    En vez de adivinar, se instrumenta la frontera:
    - timeout-minutes: 5 en el job (falla rapido en vez de comerse el runner).
    - El .exe en modo smoke escribe su traza en smoke.log y arma un watchdog
    (faulthandler.dump_traceback_later) que vuelca el STACK y sale si no termina en 60 s.
    - El CI publ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
2026-07-11 feat(entrega): scripts/preparar-entrega.sh — snapshot limpio y verificado
    Snapshot de HEAD sin historial, poda de las herramientas de desarrollo, y dos gates
    que impiden entregar a medias: (1) aborta si queda cualquier mencion en el arbol, y
    (2) corre la suite completa SOBRE EL ARBOL YA DEPURADO — la poda podria romper algo y
    el verde del repo original no lo probaria. Termina con git init + un unico commit.
2026-07-11 fix(entrega): el guion se autoexcluye del snapshot y limpia bien el README de datasheets
    Lo cazo su propio gate de verificacion: el guion se mencionaba a si mismo (no tiene
    sentido entregar el guion que prepara la entrega) y el sed del README no casaba por la
    tilde de 'aqui'.
2026-07-11 fix(ci): PyInstaller 6.21.0 — el .exe del dashboard NO ARRANCABA
    CAUSA RAIZ del cuelgue de windows-smoke, por fin medida (no inferida): PyInstaller
    6.11.1 empaqueta mal numpy 2.5.1 (sus hooks son anteriores). El .exe moria al importar
    matplotlib -> numpy con 'No module named numpy._core._exceptions'. Como se compila con
    console=False, ese error no se veia por ningun lado y el proceso se quedaba colgado: de
    ahi las 6 h de runner y los dos meses sin diagnostico.
    Esto NO era solo un fallo de CI: el ZIP que se iba a entregar al medico NO ABRIA.
2026-07-11 feat(dashboard): historia clinica del paciente y exportacion que de verdad funciona
    Tres fallos que el autor encontro USANDO la aplicacion, no los tests:
    1. "Exportar no funciona". Eran dos cosas distintas:
    - Sin sesion, el boton hacia `return` en SILENCIO: el medico pulsaba y no pasaba
    nada. Ahora avisa de por que y de donde elegir una terapia.
    - Cuando si exportaba, el archivo caia en 'dashboard/reportes/', una carpeta interna
    que el medico nunca abre (y dentro del .exe queda enterrada en el bundle). Ahora
    pregunta DONDE guardar (QFileDialog), empieza en Documentos y propone un nombre con
    el paciente y la fecha. Mismo cambio en la grafica PNG.
    (En el .exe fall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
2026-07-11 docs(roadmap): CI arreglado (el .exe no arrancaba) + historia clinica hecha
